ananyasindam-deepgrid/soc_1.1/Documentation/images/dojo.bmp

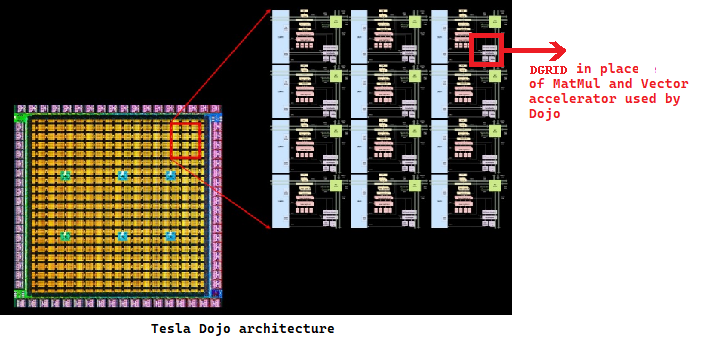
Documentation/images/dojo.bmp
