ananyasindam-deepgrid/soc_1.1/HW/riscv/xilinx_jtag/riscv.v

// Generator : SpinalHDL v1.9.3    git head : 029104c77a54c53f1edda327a3bea333f7d65fd9
// Component : riscv
// Git hash  : 5ef1bc775fdbe942875dd7906f22aa98e6cffaaf

`timescale 1ns/1ps

module riscv (
  input               io_asyncReset,
  input               io_mainClk,
  output              io_iBus_ar_valid,
  input               io_iBus_ar_ready,
  output     [31:0]   io_iBus_ar_payload_addr,
  output     [0:0]    io_iBus_ar_payload_id,
  output     [3:0]    io_iBus_ar_payload_region,
  output     [7:0]    io_iBus_ar_payload_len,
  output     [2:0]    io_iBus_ar_payload_size,
  output     [1:0]    io_iBus_ar_payload_burst,
  output     [0:0]    io_iBus_ar_payload_lock,
  output     [3:0]    io_iBus_ar_payload_cache,
  output     [3:0]    io_iBus_ar_payload_qos,
  output     [2:0]    io_iBus_ar_payload_prot,
  input               io_iBus_r_valid,
  output              io_iBus_r_ready,
  input      [31:0]   io_iBus_r_payload_data,
  input      [0:0]    io_iBus_r_payload_id,
  input      [1:0]    io_iBus_r_payload_resp,
  input               io_iBus_r_payload_last,
  output              io_dBus_aw_valid,
  input               io_dBus_aw_ready,
  output     [31:0]   io_dBus_aw_payload_addr,
  output     [0:0]    io_dBus_aw_payload_id,
  output     [3:0]    io_dBus_aw_payload_region,
  output     [7:0]    io_dBus_aw_payload_len,
  output     [2:0]    io_dBus_aw_payload_size,
  output     [1:0]    io_dBus_aw_payload_burst,
  output     [0:0]    io_dBus_aw_payload_lock,
  output     [3:0]    io_dBus_aw_payload_cache,
  output     [3:0]    io_dBus_aw_payload_qos,
  output     [2:0]    io_dBus_aw_payload_prot,
  output              io_dBus_w_valid,
  input               io_dBus_w_ready,
  output     [31:0]   io_dBus_w_payload_data,
  output     [3:0]    io_dBus_w_payload_strb,
  output              io_dBus_w_payload_last,
  input               io_dBus_b_valid,
  output              io_dBus_b_ready,
  input      [0:0]    io_dBus_b_payload_id,
  input      [1:0]    io_dBus_b_payload_resp,
  output              io_dBus_ar_valid,
  input               io_dBus_ar_ready,
  output     [31:0]   io_dBus_ar_payload_addr,
  output     [0:0]    io_dBus_ar_payload_id,
  output     [3:0]    io_dBus_ar_payload_region,
  output     [7:0]    io_dBus_ar_payload_len,
  output     [2:0]    io_dBus_ar_payload_size,
  output     [1:0]    io_dBus_ar_payload_burst,
  output     [0:0]    io_dBus_ar_payload_lock,
  output     [3:0]    io_dBus_ar_payload_cache,
  output     [3:0]    io_dBus_ar_payload_qos,
  output     [2:0]    io_dBus_ar_payload_prot,
  input               io_dBus_r_valid,
  output              io_dBus_r_ready,
  input      [31:0]   io_dBus_r_payload_data,
  input      [0:0]    io_dBus_r_payload_id,
  input      [1:0]    io_dBus_r_payload_resp,
  input               io_dBus_r_payload_last
);

  wire                system_cpu_dBus_cmd_ready;
  wire                system_cpu_dBus_rsp_payload_last;
  wire                system_cpu_dBus_rsp_payload_error;
  wire       [7:0]    system_cpu_debug_bus_cmd_payload_address;
  wire                system_cpu_iBus_rsp_payload_error;
  wire                io_asyncReset_buffercc_io_dataOut;
  wire                system_cpu_dBus_cmd_valid;
  wire                system_cpu_dBus_cmd_payload_wr;
  wire                system_cpu_dBus_cmd_payload_uncached;
  wire       [31:0]   system_cpu_dBus_cmd_payload_address;
  wire       [31:0]   system_cpu_dBus_cmd_payload_data;
  wire       [3:0]    system_cpu_dBus_cmd_payload_mask;
  wire       [2:0]    system_cpu_dBus_cmd_payload_size;
  wire                system_cpu_dBus_cmd_payload_last;
  wire                system_cpu_debug_bus_cmd_ready;
  wire       [31:0]   system_cpu_debug_bus_rsp_data;
  wire                system_cpu_debug_resetOut;
  wire                system_cpu_iBus_cmd_valid;
  wire       [31:0]   system_cpu_iBus_cmd_payload_address;
  wire       [2:0]    system_cpu_iBus_cmd_payload_size;
  wire                bSCANE2_1_CAPTURE;
  wire                bSCANE2_1_DRCK;
  wire                bSCANE2_1_RESET;
  wire                bSCANE2_1_RUNTEST;
  wire                bSCANE2_1_SEL;
  wire                bSCANE2_1_SHIFT;
  wire                bSCANE2_1_TCK;
  wire                bSCANE2_1_TDI;
  wire                bSCANE2_1_TMS;
  wire                bSCANE2_1_UPDATE;
  wire                jtagBridgeNoTap_1_io_ctrl_tdo;
  wire                jtagBridgeNoTap_1_io_remote_cmd_valid;
  wire                jtagBridgeNoTap_1_io_remote_cmd_payload_last;
  wire       [0:0]    jtagBridgeNoTap_1_io_remote_cmd_payload_fragment;
  wire                jtagBridgeNoTap_1_io_remote_rsp_ready;
  wire                systemDebugger_1_io_remote_cmd_ready;
  wire                systemDebugger_1_io_remote_rsp_valid;
  wire                systemDebugger_1_io_remote_rsp_payload_error;
  wire       [31:0]   systemDebugger_1_io_remote_rsp_payload_data;
  wire                systemDebugger_1_io_mem_cmd_valid;
  wire       [31:0]   systemDebugger_1_io_mem_cmd_payload_address;
  wire       [31:0]   systemDebugger_1_io_mem_cmd_payload_data;
  wire                systemDebugger_1_io_mem_cmd_payload_wr;
  wire       [1:0]    systemDebugger_1_io_mem_cmd_payload_size;
  wire       [2:0]    _zz_dbus_axi_arw_payload_len;
  reg                 resetCtrl_mainClkResetUnbuffered;
  reg        [5:0]    resetCtrl_systemClkResetCounter;
  wire       [5:0]    _zz_when_riscv_l155;
  wire                when_riscv_l155;
  wire                when_riscv_l159;
  reg                 resetCtrl_mainClkReset;
  reg                 resetCtrl_systemReset;
  wire                system_timerInterrupt;
  wire                system_externalInterrupt;
  wire       [0:0]    _zz_io_iBus_ar_payload_id;
  wire       [3:0]    _zz_io_iBus_ar_payload_region;
  wire                dbus_axi_arw_valid;
  wire                dbus_axi_arw_ready;
  wire       [31:0]   dbus_axi_arw_payload_addr;
  wire       [7:0]    dbus_axi_arw_payload_len;
  wire       [2:0]    dbus_axi_arw_payload_size;
  wire       [3:0]    dbus_axi_arw_payload_cache;
  wire       [2:0]    dbus_axi_arw_payload_prot;
  wire                dbus_axi_arw_payload_write;
  wire                dbus_axi_w_valid;
  wire                dbus_axi_w_ready;
  wire       [31:0]   dbus_axi_w_payload_data;
  wire       [3:0]    dbus_axi_w_payload_strb;
  wire                dbus_axi_w_payload_last;
  wire                dbus_axi_b_valid;
  wire                dbus_axi_b_ready;
  wire       [1:0]    dbus_axi_b_payload_resp;
  wire                dbus_axi_r_valid;
  wire                dbus_axi_r_ready;
  wire       [31:0]   dbus_axi_r_payload_data;
  wire       [1:0]    dbus_axi_r_payload_resp;
  wire                dbus_axi_r_payload_last;
  wire                toplevel_system_cpu_dBus_cmd_fire;
  wire                when_Utils_l659;
  wire                dbus_axi_b_fire;
  reg                 _zz_when_Utils_l687;
  reg                 _zz_when_Utils_l687_1;
  reg        [4:0]    _zz_dBus_cmd_ready;
  reg        [4:0]    _zz_dBus_cmd_ready_1;
  wire                when_Utils_l687;
  wire                when_Utils_l689;
  wire                _zz_dBus_cmd_ready_2;
  wire                _zz_dbus_axi_arw_valid;
  reg                 _zz_dBus_cmd_ready_3;
  wire                _zz_dbus_axi_arw_payload_write;
  wire                _zz_dbus_axi_w_payload_last;
  wire                _zz_dbus_axi_arw_valid_1;
  reg                 _zz_when_Stream_l998;
  wire                _zz_dbus_axi_w_valid;
  reg                 _zz_when_Stream_l998_1;
  reg                 _zz_when_Stream_l998_2;
  reg                 _zz_when_Stream_l998_3;
  wire                when_Stream_l998;
  wire                when_Stream_l998_1;
  wire                _zz_1;
  reg                 _zz_2;
  reg                 _zz_dbus_axi_arw_valid_2;
  wire                when_Stream_l439;
  reg                 _zz_dbus_axi_w_valid_1;
  wire       [0:0]    _zz_io_dBus_ar_payload_id;
  wire       [3:0]    _zz_io_dBus_ar_payload_region;
  wire       [0:0]    _zz_io_dBus_aw_payload_id;
  wire       [3:0]    _zz_io_dBus_aw_payload_region;
  reg                 toplevel_system_cpu_debug_resetOut_regNext;
  wire                toplevel_system_cpu_debug_bus_cmd_fire;
  reg                 toplevel_system_cpu_debug_bus_cmd_fire_regNext;

  assign _zz_dbus_axi_arw_payload_len = ((system_cpu_dBus_cmd_payload_size == 3'b101) ? 3'b111 : 3'b000);
  BufferCC io_asyncReset_buffercc (
    .io_dataIn  (io_asyncReset                    ), //i
    .io_dataOut (io_asyncReset_buffercc_io_dataOut), //o
    .io_mainClk (io_mainClk                       )  //i
  );
  DgsRiscv system_cpu (
    .dBus_cmd_valid                (system_cpu_dBus_cmd_valid                     ), //o
    .dBus_cmd_ready                (system_cpu_dBus_cmd_ready                     ), //i
    .dBus_cmd_payload_wr           (system_cpu_dBus_cmd_payload_wr                ), //o
    .dBus_cmd_payload_uncached     (system_cpu_dBus_cmd_payload_uncached          ), //o
    .dBus_cmd_payload_address      (system_cpu_dBus_cmd_payload_address[31:0]     ), //o
    .dBus_cmd_payload_data         (system_cpu_dBus_cmd_payload_data[31:0]        ), //o
    .dBus_cmd_payload_mask         (system_cpu_dBus_cmd_payload_mask[3:0]         ), //o
    .dBus_cmd_payload_size         (system_cpu_dBus_cmd_payload_size[2:0]         ), //o
    .dBus_cmd_payload_last         (system_cpu_dBus_cmd_payload_last              ), //o
    .dBus_rsp_valid                (dbus_axi_r_valid                              ), //i
    .dBus_rsp_payload_last         (system_cpu_dBus_rsp_payload_last              ), //i
    .dBus_rsp_payload_data         (dbus_axi_r_payload_data[31:0]                 ), //i
    .dBus_rsp_payload_error        (system_cpu_dBus_rsp_payload_error             ), //i
    .timerInterrupt                (system_timerInterrupt                         ), //i
    .externalInterrupt             (system_externalInterrupt                      ), //i
    .softwareInterrupt             (1'b0                                          ), //i
    .debug_bus_cmd_valid           (systemDebugger_1_io_mem_cmd_valid             ), //i
    .debug_bus_cmd_ready           (system_cpu_debug_bus_cmd_ready                ), //o
    .debug_bus_cmd_payload_wr      (systemDebugger_1_io_mem_cmd_payload_wr        ), //i
    .debug_bus_cmd_payload_address (system_cpu_debug_bus_cmd_payload_address[7:0] ), //i
    .debug_bus_cmd_payload_data    (systemDebugger_1_io_mem_cmd_payload_data[31:0]), //i
    .debug_bus_rsp_data            (system_cpu_debug_bus_rsp_data[31:0]           ), //o
    .debug_resetOut                (system_cpu_debug_resetOut                     ), //o
    .iBus_cmd_valid                (system_cpu_iBus_cmd_valid                     ), //o
    .iBus_cmd_ready                (io_iBus_ar_ready                              ), //i
    .iBus_cmd_payload_address      (system_cpu_iBus_cmd_payload_address[31:0]     ), //o
    .iBus_cmd_payload_size         (system_cpu_iBus_cmd_payload_size[2:0]         ), //o
    .iBus_rsp_valid                (io_iBus_r_valid                               ), //i
    .iBus_rsp_payload_data         (io_iBus_r_payload_data[31:0]                  ), //i
    .iBus_rsp_payload_error        (system_cpu_iBus_rsp_payload_error             ), //i
    .io_mainClk                    (io_mainClk                                    ), //i
    .resetCtrl_systemReset         (resetCtrl_systemReset                         ), //i
    .resetCtrl_mainClkReset        (resetCtrl_mainClkReset                        )  //i
  );
  BSCANE2 #(
    .DISABLE_JTAG("FALSE"),
    .JTAG_CHAIN(2)
  ) bSCANE2_1 (
    .CAPTURE (bSCANE2_1_CAPTURE            ), //o
    .DRCK    (bSCANE2_1_DRCK               ), //o
    .RESET   (bSCANE2_1_RESET              ), //o
    .RUNTEST (bSCANE2_1_RUNTEST            ), //o
    .SEL     (bSCANE2_1_SEL                ), //o
    .SHIFT   (bSCANE2_1_SHIFT              ), //o
    .TCK     (bSCANE2_1_TCK                ), //o
    .TDI     (bSCANE2_1_TDI                ), //o
    .TMS     (bSCANE2_1_TMS                ), //o
    .UPDATE  (bSCANE2_1_UPDATE             ), //o
    .TDO     (jtagBridgeNoTap_1_io_ctrl_tdo)  //i
  );
  JtagBridgeNoTap jtagBridgeNoTap_1 (
    .io_ctrl_tdi                    (bSCANE2_1_TDI                                    ), //i
    .io_ctrl_enable                 (bSCANE2_1_SEL                                    ), //i
    .io_ctrl_capture                (bSCANE2_1_CAPTURE                                ), //i
    .io_ctrl_shift                  (bSCANE2_1_SHIFT                                  ), //i
    .io_ctrl_update                 (bSCANE2_1_UPDATE                                 ), //i
    .io_ctrl_reset                  (bSCANE2_1_RESET                                  ), //i
    .io_ctrl_tdo                    (jtagBridgeNoTap_1_io_ctrl_tdo                    ), //o
    .io_remote_cmd_valid            (jtagBridgeNoTap_1_io_remote_cmd_valid            ), //o
    .io_remote_cmd_ready            (systemDebugger_1_io_remote_cmd_ready             ), //i
    .io_remote_cmd_payload_last     (jtagBridgeNoTap_1_io_remote_cmd_payload_last     ), //o
    .io_remote_cmd_payload_fragment (jtagBridgeNoTap_1_io_remote_cmd_payload_fragment ), //o
    .io_remote_rsp_valid            (systemDebugger_1_io_remote_rsp_valid             ), //i
    .io_remote_rsp_ready            (jtagBridgeNoTap_1_io_remote_rsp_ready            ), //o
    .io_remote_rsp_payload_error    (systemDebugger_1_io_remote_rsp_payload_error     ), //i
    .io_remote_rsp_payload_data     (systemDebugger_1_io_remote_rsp_payload_data[31:0]), //i
    .io_mainClk                     (io_mainClk                                       ), //i
    .resetCtrl_mainClkReset         (resetCtrl_mainClkReset                           ), //i
    .TCK                            (bSCANE2_1_TCK                                    )  //i
  );
  SystemDebugger systemDebugger_1 (
    .io_remote_cmd_valid            (jtagBridgeNoTap_1_io_remote_cmd_valid            ), //i
    .io_remote_cmd_ready            (systemDebugger_1_io_remote_cmd_ready             ), //o
    .io_remote_cmd_payload_last     (jtagBridgeNoTap_1_io_remote_cmd_payload_last     ), //i
    .io_remote_cmd_payload_fragment (jtagBridgeNoTap_1_io_remote_cmd_payload_fragment ), //i
    .io_remote_rsp_valid            (systemDebugger_1_io_remote_rsp_valid             ), //o
    .io_remote_rsp_ready            (jtagBridgeNoTap_1_io_remote_rsp_ready            ), //i
    .io_remote_rsp_payload_error    (systemDebugger_1_io_remote_rsp_payload_error     ), //o
    .io_remote_rsp_payload_data     (systemDebugger_1_io_remote_rsp_payload_data[31:0]), //o
    .io_mem_cmd_valid               (systemDebugger_1_io_mem_cmd_valid                ), //o
    .io_mem_cmd_ready               (system_cpu_debug_bus_cmd_ready                   ), //i
    .io_mem_cmd_payload_address     (systemDebugger_1_io_mem_cmd_payload_address[31:0]), //o
    .io_mem_cmd_payload_data        (systemDebugger_1_io_mem_cmd_payload_data[31:0]   ), //o
    .io_mem_cmd_payload_wr          (systemDebugger_1_io_mem_cmd_payload_wr           ), //o
    .io_mem_cmd_payload_size        (systemDebugger_1_io_mem_cmd_payload_size[1:0]    ), //o
    .io_mem_rsp_valid               (toplevel_system_cpu_debug_bus_cmd_fire_regNext   ), //i
    .io_mem_rsp_payload             (system_cpu_debug_bus_rsp_data[31:0]              ), //i
    .io_mainClk                     (io_mainClk                                       ), //i
    .resetCtrl_mainClkReset         (resetCtrl_mainClkReset                           )  //i
  );
  initial begin
    resetCtrl_systemClkResetCounter = 6'h00;
  end

  always @(*) begin
    resetCtrl_mainClkResetUnbuffered = 1'b0;
    if(when_riscv_l155) begin
      resetCtrl_mainClkResetUnbuffered = 1'b1;
    end
  end

  assign _zz_when_riscv_l155[5 : 0] = 6'h3f;
  assign when_riscv_l155 = (resetCtrl_systemClkResetCounter != _zz_when_riscv_l155);
  assign when_riscv_l159 = io_asyncReset_buffercc_io_dataOut;
  assign system_timerInterrupt = 1'b0;
  assign system_externalInterrupt = 1'b0;
  assign system_cpu_iBus_rsp_payload_error = (! (io_iBus_r_payload_resp == 2'b00));
  assign _zz_io_iBus_ar_payload_id[0 : 0] = 1'b0;
  assign _zz_io_iBus_ar_payload_region[3 : 0] = 4'b0000;
  assign toplevel_system_cpu_dBus_cmd_fire = (system_cpu_dBus_cmd_valid && system_cpu_dBus_cmd_ready);
  assign when_Utils_l659 = (toplevel_system_cpu_dBus_cmd_fire && system_cpu_dBus_cmd_payload_wr);
  assign dbus_axi_b_fire = (dbus_axi_b_valid && dbus_axi_b_ready);
  always @(*) begin
    _zz_when_Utils_l687 = 1'b0;
    if(when_Utils_l659) begin
      _zz_when_Utils_l687 = 1'b1;
    end
  end

  always @(*) begin
    _zz_when_Utils_l687_1 = 1'b0;
    if(dbus_axi_b_fire) begin
      _zz_when_Utils_l687_1 = 1'b1;
    end
  end

  assign when_Utils_l687 = (_zz_when_Utils_l687 && (! _zz_when_Utils_l687_1));
  always @(*) begin
    if(when_Utils_l687) begin
      _zz_dBus_cmd_ready_1 = 5'h01;
    end else begin
      if(when_Utils_l689) begin
        _zz_dBus_cmd_ready_1 = 5'h1f;
      end else begin
        _zz_dBus_cmd_ready_1 = 5'h00;
      end
    end
  end

  assign when_Utils_l689 = ((! _zz_when_Utils_l687) && _zz_when_Utils_l687_1);
  assign _zz_dBus_cmd_ready_2 = (! (((_zz_dBus_cmd_ready != 5'h00) && (! system_cpu_dBus_cmd_payload_wr)) || (_zz_dBus_cmd_ready == 5'h1f)));
  assign _zz_dbus_axi_arw_valid = (system_cpu_dBus_cmd_valid && _zz_dBus_cmd_ready_2);
  assign system_cpu_dBus_cmd_ready = (_zz_dBus_cmd_ready_3 && _zz_dBus_cmd_ready_2);
  assign _zz_dbus_axi_arw_payload_write = system_cpu_dBus_cmd_payload_wr;
  assign _zz_dbus_axi_w_payload_last = system_cpu_dBus_cmd_payload_last;
  always @(*) begin
    _zz_dBus_cmd_ready_3 = 1'b1;
    if(when_Stream_l998) begin
      _zz_dBus_cmd_ready_3 = 1'b0;
    end
    if(when_Stream_l998_1) begin
      _zz_dBus_cmd_ready_3 = 1'b0;
    end
  end

  assign when_Stream_l998 = ((! _zz_when_Stream_l998) && _zz_when_Stream_l998_2);
  assign when_Stream_l998_1 = ((! _zz_when_Stream_l998_1) && _zz_when_Stream_l998_3);
  assign _zz_dbus_axi_arw_valid_1 = (_zz_dbus_axi_arw_valid && _zz_when_Stream_l998_2);
  assign _zz_1 = (_zz_dbus_axi_arw_valid_1 && _zz_when_Stream_l998);
  assign _zz_dbus_axi_w_valid = (_zz_dbus_axi_arw_valid && _zz_when_Stream_l998_3);
  always @(*) begin
    _zz_dbus_axi_arw_valid_2 = _zz_dbus_axi_arw_valid_1;
    if(_zz_2) begin
      _zz_dbus_axi_arw_valid_2 = 1'b0;
    end
  end

  always @(*) begin
    _zz_when_Stream_l998 = dbus_axi_arw_ready;
    if(_zz_2) begin
      _zz_when_Stream_l998 = 1'b1;
    end
  end

  assign when_Stream_l439 = (! _zz_dbus_axi_arw_payload_write);
  always @(*) begin
    _zz_dbus_axi_w_valid_1 = _zz_dbus_axi_w_valid;
    if(when_Stream_l439) begin
      _zz_dbus_axi_w_valid_1 = 1'b0;
    end
  end

  always @(*) begin
    _zz_when_Stream_l998_1 = dbus_axi_w_ready;
    if(when_Stream_l439) begin
      _zz_when_Stream_l998_1 = 1'b1;
    end
  end

  assign dbus_axi_arw_valid = _zz_dbus_axi_arw_valid_2;
  assign dbus_axi_arw_payload_write = _zz_dbus_axi_arw_payload_write;
  assign dbus_axi_arw_payload_prot = 3'b010;
  assign dbus_axi_arw_payload_cache = 4'b1111;
  assign dbus_axi_arw_payload_size = 3'b010;
  assign dbus_axi_arw_payload_addr = system_cpu_dBus_cmd_payload_address;
  assign dbus_axi_arw_payload_len = {5'd0, _zz_dbus_axi_arw_payload_len};
  assign dbus_axi_w_valid = _zz_dbus_axi_w_valid_1;
  assign dbus_axi_w_payload_data = system_cpu_dBus_cmd_payload_data;
  assign dbus_axi_w_payload_strb = system_cpu_dBus_cmd_payload_mask;
  assign dbus_axi_w_payload_last = _zz_dbus_axi_w_payload_last;
  assign system_cpu_dBus_rsp_payload_error = (! (dbus_axi_r_payload_resp == 2'b00));
  assign dbus_axi_r_ready = 1'b1;
  assign dbus_axi_b_ready = 1'b1;
  assign dbus_axi_arw_ready = (dbus_axi_arw_payload_write ? io_dBus_aw_ready : io_dBus_ar_ready);
  assign dbus_axi_w_ready = io_dBus_w_ready;
  assign dbus_axi_r_valid = io_dBus_r_valid;
  assign dbus_axi_r_payload_data = io_dBus_r_payload_data;
  assign dbus_axi_r_payload_resp = io_dBus_r_payload_resp;
  assign dbus_axi_r_payload_last = io_dBus_r_payload_last;
  assign dbus_axi_b_valid = io_dBus_b_valid;
  assign dbus_axi_b_payload_resp = io_dBus_b_payload_resp;
  assign _zz_io_dBus_ar_payload_id[0 : 0] = 1'b0;
  assign _zz_io_dBus_ar_payload_region[3 : 0] = 4'b0000;
  assign _zz_io_dBus_aw_payload_id[0 : 0] = 1'b0;
  assign _zz_io_dBus_aw_payload_region[3 : 0] = 4'b0000;
  assign system_cpu_debug_bus_cmd_payload_address = systemDebugger_1_io_mem_cmd_payload_address[7:0];
  assign toplevel_system_cpu_debug_bus_cmd_fire = (systemDebugger_1_io_mem_cmd_valid && system_cpu_debug_bus_cmd_ready);
  assign io_iBus_ar_valid = system_cpu_iBus_cmd_valid;
  assign io_iBus_ar_payload_addr = system_cpu_iBus_cmd_payload_address;
  assign io_iBus_ar_payload_id = _zz_io_iBus_ar_payload_id;
  assign io_iBus_ar_payload_region = _zz_io_iBus_ar_payload_region;
  assign io_iBus_ar_payload_len = 8'h07;
  assign io_iBus_ar_payload_size = 3'b010;
  assign io_iBus_ar_payload_burst = 2'b01;
  assign io_iBus_ar_payload_lock = 1'b0;
  assign io_iBus_ar_payload_cache = 4'b1111;
  assign io_iBus_ar_payload_qos = 4'b0000;
  assign io_iBus_ar_payload_prot = 3'b110;
  assign io_iBus_r_ready = 1'b1;
  assign io_dBus_aw_valid = (dbus_axi_arw_valid && dbus_axi_arw_payload_write);
  assign io_dBus_aw_payload_addr = dbus_axi_arw_payload_addr;
  assign io_dBus_aw_payload_id = _zz_io_dBus_aw_payload_id;
  assign io_dBus_aw_payload_region = _zz_io_dBus_aw_payload_region;
  assign io_dBus_aw_payload_len = dbus_axi_arw_payload_len;
  assign io_dBus_aw_payload_size = dbus_axi_arw_payload_size;
  assign io_dBus_aw_payload_burst = 2'b01;
  assign io_dBus_aw_payload_lock = 1'b0;
  assign io_dBus_aw_payload_cache = dbus_axi_arw_payload_cache;
  assign io_dBus_aw_payload_qos = 4'b0000;
  assign io_dBus_aw_payload_prot = dbus_axi_arw_payload_prot;
  assign io_dBus_w_valid = dbus_axi_w_valid;
  assign io_dBus_w_payload_data = dbus_axi_w_payload_data;
  assign io_dBus_w_payload_strb = dbus_axi_w_payload_strb;
  assign io_dBus_w_payload_last = dbus_axi_w_payload_last;
  assign io_dBus_b_ready = dbus_axi_b_ready;
  assign io_dBus_ar_valid = (dbus_axi_arw_valid && (! dbus_axi_arw_payload_write));
  assign io_dBus_ar_payload_addr = dbus_axi_arw_payload_addr;
  assign io_dBus_ar_payload_id = _zz_io_dBus_ar_payload_id;
  assign io_dBus_ar_payload_region = _zz_io_dBus_ar_payload_region;
  assign io_dBus_ar_payload_len = dbus_axi_arw_payload_len;
  assign io_dBus_ar_payload_size = dbus_axi_arw_payload_size;
  assign io_dBus_ar_payload_burst = 2'b01;
  assign io_dBus_ar_payload_lock = 1'b0;
  assign io_dBus_ar_payload_cache = dbus_axi_arw_payload_cache;
  assign io_dBus_ar_payload_qos = 4'b0000;
  assign io_dBus_ar_payload_prot = dbus_axi_arw_payload_prot;
  assign io_dBus_r_ready = dbus_axi_r_ready;
  always @(posedge io_mainClk) begin
    if(when_riscv_l155) begin
      resetCtrl_systemClkResetCounter <= (resetCtrl_systemClkResetCounter + 6'h01);
    end
    if(when_riscv_l159) begin
      resetCtrl_systemClkResetCounter <= 6'h00;
    end
  end

  always @(posedge io_mainClk) begin
    resetCtrl_mainClkReset <= resetCtrl_mainClkResetUnbuffered;
    resetCtrl_systemReset <= resetCtrl_mainClkResetUnbuffered;
    if(toplevel_system_cpu_debug_resetOut_regNext) begin
      resetCtrl_systemReset <= 1'b1;
    end
  end

  always @(posedge io_mainClk or posedge resetCtrl_systemReset) begin
    if(resetCtrl_systemReset) begin
      _zz_dBus_cmd_ready <= 5'h00;
      _zz_when_Stream_l998_2 <= 1'b1;
      _zz_when_Stream_l998_3 <= 1'b1;
      _zz_2 <= 1'b0;
    end else begin
      _zz_dBus_cmd_ready <= (_zz_dBus_cmd_ready + _zz_dBus_cmd_ready_1);
      if(_zz_1) begin
        _zz_when_Stream_l998_2 <= 1'b0;
      end
      if((_zz_dbus_axi_w_valid && _zz_when_Stream_l998_1)) begin
        _zz_when_Stream_l998_3 <= 1'b0;
      end
      if(_zz_dBus_cmd_ready_3) begin
        _zz_when_Stream_l998_2 <= 1'b1;
        _zz_when_Stream_l998_3 <= 1'b1;
      end
      if(_zz_1) begin
        _zz_2 <= (! _zz_dbus_axi_w_payload_last);
      end
    end
  end

  always @(posedge io_mainClk) begin
    toplevel_system_cpu_debug_resetOut_regNext <= system_cpu_debug_resetOut;
  end

  always @(posedge io_mainClk or posedge resetCtrl_mainClkReset) begin
    if(resetCtrl_mainClkReset) begin
      toplevel_system_cpu_debug_bus_cmd_fire_regNext <= 1'b0;
    end else begin
      toplevel_system_cpu_debug_bus_cmd_fire_regNext <= toplevel_system_cpu_debug_bus_cmd_fire;
    end
  end


endmodule

module SystemDebugger (
  input               io_remote_cmd_valid,
  output              io_remote_cmd_ready,
  input               io_remote_cmd_payload_last,
  input      [0:0]    io_remote_cmd_payload_fragment,
  output              io_remote_rsp_valid,
  input               io_remote_rsp_ready,
  output              io_remote_rsp_payload_error,
  output     [31:0]   io_remote_rsp_payload_data,
  output              io_mem_cmd_valid,
  input               io_mem_cmd_ready,
  output     [31:0]   io_mem_cmd_payload_address,
  output     [31:0]   io_mem_cmd_payload_data,
  output              io_mem_cmd_payload_wr,
  output     [1:0]    io_mem_cmd_payload_size,
  input               io_mem_rsp_valid,
  input      [31:0]   io_mem_rsp_payload,
  input               io_mainClk,
  input               resetCtrl_mainClkReset
);

  reg        [66:0]   dispatcher_dataShifter;
  reg                 dispatcher_dataLoaded;
  reg        [7:0]    dispatcher_headerShifter;
  wire       [7:0]    dispatcher_header;
  reg                 dispatcher_headerLoaded;
  reg        [2:0]    dispatcher_counter;
  wire                when_Fragment_l356;
  wire                when_Fragment_l359;
  wire       [66:0]   _zz_io_mem_cmd_payload_address;
  wire                io_mem_cmd_isStall;
  wire                when_Fragment_l382;

  assign dispatcher_header = dispatcher_headerShifter[7 : 0];
  assign when_Fragment_l356 = (dispatcher_headerLoaded == 1'b0);
  assign when_Fragment_l359 = (dispatcher_counter == 3'b111);
  assign io_remote_cmd_ready = (! dispatcher_dataLoaded);
  assign _zz_io_mem_cmd_payload_address = dispatcher_dataShifter[66 : 0];
  assign io_mem_cmd_payload_address = _zz_io_mem_cmd_payload_address[31 : 0];
  assign io_mem_cmd_payload_data = _zz_io_mem_cmd_payload_address[63 : 32];
  assign io_mem_cmd_payload_wr = _zz_io_mem_cmd_payload_address[64];
  assign io_mem_cmd_payload_size = _zz_io_mem_cmd_payload_address[66 : 65];
  assign io_mem_cmd_valid = (dispatcher_dataLoaded && (dispatcher_header == 8'h00));
  assign io_mem_cmd_isStall = (io_mem_cmd_valid && (! io_mem_cmd_ready));
  assign when_Fragment_l382 = ((dispatcher_headerLoaded && dispatcher_dataLoaded) && (! io_mem_cmd_isStall));
  assign io_remote_rsp_valid = io_mem_rsp_valid;
  assign io_remote_rsp_payload_error = 1'b0;
  assign io_remote_rsp_payload_data = io_mem_rsp_payload;
  always @(posedge io_mainClk or posedge resetCtrl_mainClkReset) begin
    if(resetCtrl_mainClkReset) begin
      dispatcher_dataLoaded <= 1'b0;
      dispatcher_headerLoaded <= 1'b0;
      dispatcher_counter <= 3'b000;
    end else begin
      if(io_remote_cmd_valid) begin
        if(when_Fragment_l356) begin
          dispatcher_counter <= (dispatcher_counter + 3'b001);
          if(when_Fragment_l359) begin
            dispatcher_headerLoaded <= 1'b1;
          end
        end
        if(io_remote_cmd_payload_last) begin
          dispatcher_headerLoaded <= 1'b1;
          dispatcher_dataLoaded <= 1'b1;
          dispatcher_counter <= 3'b000;
        end
      end
      if(when_Fragment_l382) begin
        dispatcher_headerLoaded <= 1'b0;
        dispatcher_dataLoaded <= 1'b0;
      end
    end
  end

  always @(posedge io_mainClk) begin
    if(io_remote_cmd_valid) begin
      if(when_Fragment_l356) begin
        dispatcher_headerShifter <= ({io_remote_cmd_payload_fragment,dispatcher_headerShifter} >>> 1'd1);
      end else begin
        dispatcher_dataShifter <= ({io_remote_cmd_payload_fragment,dispatcher_dataShifter} >>> 1'd1);
      end
    end
  end


endmodule

module JtagBridgeNoTap (
  input               io_ctrl_tdi,
  input               io_ctrl_enable,
  input               io_ctrl_capture,
  input               io_ctrl_shift,
  input               io_ctrl_update,
  input               io_ctrl_reset,
  output              io_ctrl_tdo,
  output              io_remote_cmd_valid,
  input               io_remote_cmd_ready,
  output              io_remote_cmd_payload_last,
  output     [0:0]    io_remote_cmd_payload_fragment,
  input               io_remote_rsp_valid,
  output              io_remote_rsp_ready,
  input               io_remote_rsp_payload_error,
  input      [31:0]   io_remote_rsp_payload_data,
  input               io_mainClk,
  input               resetCtrl_mainClkReset,
  input               TCK
);

  wire                flowCCByToggle_1_io_output_valid;
  wire                flowCCByToggle_1_io_output_payload_last;
  wire       [0:0]    flowCCByToggle_1_io_output_payload_fragment;
  wire                system_cmd_valid;
  wire                system_cmd_payload_last;
  wire       [0:0]    system_cmd_payload_fragment;
  wire                system_cmd_toStream_valid;
  wire                system_cmd_toStream_ready;
  wire                system_cmd_toStream_payload_last;
  wire       [0:0]    system_cmd_toStream_payload_fragment;
  (* async_reg = "true" *) reg                 system_rsp_valid;
  (* async_reg = "true" *) reg                 system_rsp_payload_error;
  (* async_reg = "true" *) reg        [31:0]   system_rsp_payload_data;
  wire                io_remote_rsp_fire;
  wire                jtag_wrapper_ctrl_tdi;
  wire                jtag_wrapper_ctrl_enable;
  wire                jtag_wrapper_ctrl_capture;
  wire                jtag_wrapper_ctrl_shift;
  wire                jtag_wrapper_ctrl_update;
  wire                jtag_wrapper_ctrl_reset;
  reg                 jtag_wrapper_ctrl_tdo;
  reg        [1:0]    jtag_wrapper_header;
  wire       [1:0]    jtag_wrapper_headerNext;
  reg        [0:0]    jtag_wrapper_counter;
  reg                 jtag_wrapper_done;
  reg                 jtag_wrapper_sendCapture;
  reg                 jtag_wrapper_sendShift;
  reg                 jtag_wrapper_sendUpdate;
  wire                when_JtagTapInstructions_l183;
  wire                when_JtagTapInstructions_l186;
  wire                jtag_writeArea_ctrl_tdi;
  wire                jtag_writeArea_ctrl_enable;
  wire                jtag_writeArea_ctrl_capture;
  wire                jtag_writeArea_ctrl_shift;
  wire                jtag_writeArea_ctrl_update;
  wire                jtag_writeArea_ctrl_reset;
  wire                jtag_writeArea_ctrl_tdo;
  wire                jtag_writeArea_source_valid;
  wire                jtag_writeArea_source_payload_last;
  wire       [0:0]    jtag_writeArea_source_payload_fragment;
  reg                 jtag_writeArea_valid;
  reg                 jtag_writeArea_data;
  wire                when_JtagTapInstructions_l209;
  wire                jtag_readArea_ctrl_tdi;
  wire                jtag_readArea_ctrl_enable;
  wire                jtag_readArea_ctrl_capture;
  wire                jtag_readArea_ctrl_shift;
  wire                jtag_readArea_ctrl_update;
  wire                jtag_readArea_ctrl_reset;
  wire                jtag_readArea_ctrl_tdo;
  reg        [33:0]   jtag_readArea_full_shifter;
  wire                when_JtagTapInstructions_l209_1;

  FlowCCByToggle flowCCByToggle_1 (
    .io_input_valid             (jtag_writeArea_source_valid                ), //i
    .io_input_payload_last      (jtag_writeArea_source_payload_last         ), //i
    .io_input_payload_fragment  (jtag_writeArea_source_payload_fragment     ), //i
    .io_output_valid            (flowCCByToggle_1_io_output_valid           ), //o
    .io_output_payload_last     (flowCCByToggle_1_io_output_payload_last    ), //o
    .io_output_payload_fragment (flowCCByToggle_1_io_output_payload_fragment), //o
    .TCK                        (TCK                                        ), //i
    .io_mainClk                 (io_mainClk                                 ), //i
    .resetCtrl_mainClkReset     (resetCtrl_mainClkReset                     )  //i
  );
  assign system_cmd_toStream_valid = system_cmd_valid;
  assign system_cmd_toStream_payload_last = system_cmd_payload_last;
  assign system_cmd_toStream_payload_fragment = system_cmd_payload_fragment;
  assign io_remote_cmd_valid = system_cmd_toStream_valid;
  assign system_cmd_toStream_ready = io_remote_cmd_ready;
  assign io_remote_cmd_payload_last = system_cmd_toStream_payload_last;
  assign io_remote_cmd_payload_fragment = system_cmd_toStream_payload_fragment;
  assign io_remote_rsp_fire = (io_remote_rsp_valid && io_remote_rsp_ready);
  assign io_remote_rsp_ready = 1'b1;
  assign jtag_wrapper_headerNext = ({jtag_wrapper_ctrl_tdi,jtag_wrapper_header} >>> 1'd1);
  always @(*) begin
    jtag_wrapper_sendCapture = 1'b0;
    if(jtag_wrapper_ctrl_enable) begin
      if(jtag_wrapper_ctrl_shift) begin
        if(when_JtagTapInstructions_l183) begin
          if(when_JtagTapInstructions_l186) begin
            jtag_wrapper_sendCapture = 1'b1;
          end
        end
      end
    end
  end

  always @(*) begin
    jtag_wrapper_sendShift = 1'b0;
    if(jtag_wrapper_ctrl_enable) begin
      if(jtag_wrapper_ctrl_shift) begin
        if(!when_JtagTapInstructions_l183) begin
          jtag_wrapper_sendShift = 1'b1;
        end
      end
    end
  end

  always @(*) begin
    jtag_wrapper_sendUpdate = 1'b0;
    if(jtag_wrapper_ctrl_enable) begin
      if(jtag_wrapper_ctrl_update) begin
        jtag_wrapper_sendUpdate = 1'b1;
      end
    end
  end

  assign when_JtagTapInstructions_l183 = (! jtag_wrapper_done);
  assign when_JtagTapInstructions_l186 = (jtag_wrapper_counter == 1'b1);
  always @(*) begin
    jtag_wrapper_ctrl_tdo = 1'b0;
    if(when_JtagTapInstructions_l209) begin
      jtag_wrapper_ctrl_tdo = jtag_writeArea_ctrl_tdo;
    end
    if(when_JtagTapInstructions_l209_1) begin
      jtag_wrapper_ctrl_tdo = jtag_readArea_ctrl_tdo;
    end
  end

  assign jtag_wrapper_ctrl_tdi = io_ctrl_tdi;
  assign jtag_wrapper_ctrl_enable = io_ctrl_enable;
  assign jtag_wrapper_ctrl_capture = io_ctrl_capture;
  assign jtag_wrapper_ctrl_shift = io_ctrl_shift;
  assign jtag_wrapper_ctrl_update = io_ctrl_update;
  assign jtag_wrapper_ctrl_reset = io_ctrl_reset;
  assign io_ctrl_tdo = jtag_wrapper_ctrl_tdo;
  assign jtag_writeArea_source_valid = jtag_writeArea_valid;
  assign jtag_writeArea_source_payload_last = (! (jtag_writeArea_ctrl_enable && jtag_writeArea_ctrl_shift));
  assign jtag_writeArea_source_payload_fragment[0] = jtag_writeArea_data;
  assign system_cmd_valid = flowCCByToggle_1_io_output_valid;
  assign system_cmd_payload_last = flowCCByToggle_1_io_output_payload_last;
  assign system_cmd_payload_fragment = flowCCByToggle_1_io_output_payload_fragment;
  assign jtag_writeArea_ctrl_tdo = 1'b0;
  assign when_JtagTapInstructions_l209 = (jtag_wrapper_header == 2'b00);
  assign jtag_writeArea_ctrl_tdi = jtag_wrapper_ctrl_tdi;
  assign jtag_writeArea_ctrl_enable = 1'b1;
  assign jtag_writeArea_ctrl_capture = ((jtag_wrapper_headerNext == 2'b00) && jtag_wrapper_sendCapture);
  assign jtag_writeArea_ctrl_shift = (when_JtagTapInstructions_l209 && jtag_wrapper_sendShift);
  assign jtag_writeArea_ctrl_update = (when_JtagTapInstructions_l209 && jtag_wrapper_sendUpdate);
  assign jtag_writeArea_ctrl_reset = jtag_wrapper_ctrl_reset;
  assign jtag_readArea_ctrl_tdo = jtag_readArea_full_shifter[0];
  assign when_JtagTapInstructions_l209_1 = (jtag_wrapper_header == 2'b01);
  assign jtag_readArea_ctrl_tdi = jtag_wrapper_ctrl_tdi;
  assign jtag_readArea_ctrl_enable = 1'b1;
  assign jtag_readArea_ctrl_capture = ((jtag_wrapper_headerNext == 2'b01) && jtag_wrapper_sendCapture);
  assign jtag_readArea_ctrl_shift = (when_JtagTapInstructions_l209_1 && jtag_wrapper_sendShift);
  assign jtag_readArea_ctrl_update = (when_JtagTapInstructions_l209_1 && jtag_wrapper_sendUpdate);
  assign jtag_readArea_ctrl_reset = jtag_wrapper_ctrl_reset;
  always @(posedge io_mainClk) begin
    if(io_remote_cmd_valid) begin
      system_rsp_valid <= 1'b0;
    end
    if(io_remote_rsp_fire) begin
      system_rsp_valid <= 1'b1;
      system_rsp_payload_error <= io_remote_rsp_payload_error;
      system_rsp_payload_data <= io_remote_rsp_payload_data;
    end
  end

  always @(posedge TCK) begin
    if(jtag_wrapper_ctrl_enable) begin
      if(jtag_wrapper_ctrl_capture) begin
        jtag_wrapper_done <= 1'b0;
        jtag_wrapper_counter <= 1'b0;
      end
      if(jtag_wrapper_ctrl_shift) begin
        if(when_JtagTapInstructions_l183) begin
          jtag_wrapper_counter <= (jtag_wrapper_counter + 1'b1);
          jtag_wrapper_header <= jtag_wrapper_headerNext;
          if(when_JtagTapInstructions_l186) begin
            jtag_wrapper_done <= 1'b1;
          end
        end
      end
    end
    jtag_writeArea_valid <= (jtag_writeArea_ctrl_enable && jtag_writeArea_ctrl_shift);
    jtag_writeArea_data <= jtag_writeArea_ctrl_tdi;
    if(jtag_readArea_ctrl_enable) begin
      if(jtag_readArea_ctrl_capture) begin
        jtag_readArea_full_shifter <= {{system_rsp_payload_data,system_rsp_payload_error},system_rsp_valid};
      end
      if(jtag_readArea_ctrl_shift) begin
        jtag_readArea_full_shifter <= ({jtag_readArea_ctrl_tdi,jtag_readArea_full_shifter} >>> 1'd1);
      end
    end
  end


endmodule

module DgsRiscv (
  output              dBus_cmd_valid,
  input               dBus_cmd_ready,
  output              dBus_cmd_payload_wr,
  output              dBus_cmd_payload_uncached,
  output     [31:0]   dBus_cmd_payload_address,
  output     [31:0]   dBus_cmd_payload_data,
  output     [3:0]    dBus_cmd_payload_mask,
  output     [2:0]    dBus_cmd_payload_size,
  output              dBus_cmd_payload_last,
  input               dBus_rsp_valid,
  input               dBus_rsp_payload_last,
  input      [31:0]   dBus_rsp_payload_data,
  input               dBus_rsp_payload_error,
  input               timerInterrupt,
  input               externalInterrupt,
  input               softwareInterrupt,
  input               debug_bus_cmd_valid,
  output reg          debug_bus_cmd_ready,
  input               debug_bus_cmd_payload_wr,
  input      [7:0]    debug_bus_cmd_payload_address,
  input      [31:0]   debug_bus_cmd_payload_data,
  output reg [31:0]   debug_bus_rsp_data,
  output              debug_resetOut,
  output              iBus_cmd_valid,
  input               iBus_cmd_ready,
  output reg [31:0]   iBus_cmd_payload_address,
  output     [2:0]    iBus_cmd_payload_size,
  input               iBus_rsp_valid,
  input      [31:0]   iBus_rsp_payload_data,
  input               iBus_rsp_payload_error,
  input               io_mainClk,
  input               resetCtrl_systemReset,
  input               resetCtrl_mainClkReset
);
  localparam BranchCtrlEnum_INC = 2'd0;
  localparam BranchCtrlEnum_B = 2'd1;
  localparam BranchCtrlEnum_JAL = 2'd2;
  localparam BranchCtrlEnum_JALR = 2'd3;
  localparam ShiftCtrlEnum_DISABLE_1 = 2'd0;
  localparam ShiftCtrlEnum_SLL_1 = 2'd1;
  localparam ShiftCtrlEnum_SRL_1 = 2'd2;
  localparam ShiftCtrlEnum_SRA_1 = 2'd3;
  localparam AluBitwiseCtrlEnum_XOR_1 = 2'd0;
  localparam AluBitwiseCtrlEnum_OR_1 = 2'd1;
  localparam AluBitwiseCtrlEnum_AND_1 = 2'd2;
  localparam EnvCtrlEnum_NONE = 1'd0;
  localparam EnvCtrlEnum_XRET = 1'd1;
  localparam Src2CtrlEnum_RS = 2'd0;
  localparam Src2CtrlEnum_IMI = 2'd1;
  localparam Src2CtrlEnum_IMS = 2'd2;
  localparam Src2CtrlEnum_PC = 2'd3;
  localparam AluCtrlEnum_ADD_SUB = 2'd0;
  localparam AluCtrlEnum_SLT_SLTU = 2'd1;
  localparam AluCtrlEnum_BITWISE = 2'd2;
  localparam Src1CtrlEnum_RS = 2'd0;
  localparam Src1CtrlEnum_IMU = 2'd1;
  localparam Src1CtrlEnum_PC_INCREMENT = 2'd2;
  localparam Src1CtrlEnum_URS1 = 2'd3;

  wire                IBusCachedPlugin_cache_io_flush;
  wire                IBusCachedPlugin_cache_io_cpu_prefetch_isValid;
  wire                IBusCachedPlugin_cache_io_cpu_fetch_isValid;
  wire                IBusCachedPlugin_cache_io_cpu_fetch_isStuck;
  wire                IBusCachedPlugin_cache_io_cpu_fetch_isRemoved;
  wire                IBusCachedPlugin_cache_io_cpu_decode_isValid;
  wire                IBusCachedPlugin_cache_io_cpu_decode_isStuck;
  wire                IBusCachedPlugin_cache_io_cpu_decode_isUser;
  reg                 IBusCachedPlugin_cache_io_cpu_fill_valid;
  wire                dataCache_1_io_cpu_execute_isValid;
  wire       [31:0]   dataCache_1_io_cpu_execute_address;
  wire                dataCache_1_io_cpu_memory_isValid;
  wire       [31:0]   dataCache_1_io_cpu_memory_address;
  reg                 dataCache_1_io_cpu_memory_mmuRsp_isIoAccess;
  reg                 dataCache_1_io_cpu_writeBack_isValid;
  wire                dataCache_1_io_cpu_writeBack_isUser;
  wire       [31:0]   dataCache_1_io_cpu_writeBack_storeData;
  wire       [31:0]   dataCache_1_io_cpu_writeBack_address;
  wire                dataCache_1_io_cpu_writeBack_fence_SW;
  wire                dataCache_1_io_cpu_writeBack_fence_SR;
  wire                dataCache_1_io_cpu_writeBack_fence_SO;
  wire                dataCache_1_io_cpu_writeBack_fence_SI;
  wire                dataCache_1_io_cpu_writeBack_fence_PW;
  wire                dataCache_1_io_cpu_writeBack_fence_PR;
  wire                dataCache_1_io_cpu_writeBack_fence_PO;
  wire                dataCache_1_io_cpu_writeBack_fence_PI;
  wire       [3:0]    dataCache_1_io_cpu_writeBack_fence_FM;
  wire                dataCache_1_io_cpu_flush_valid;
  wire                dataCache_1_io_cpu_flush_payload_singleLine;
  wire       [7:0]    dataCache_1_io_cpu_flush_payload_lineId;
  reg        [55:0]   _zz_IBusCachedPlugin_predictor_history_port1;
  wire       [31:0]   _zz_RegFilePlugin_regFile_port0;
  wire       [31:0]   _zz_RegFilePlugin_regFile_port1;
  wire                IBusCachedPlugin_cache_io_cpu_prefetch_haltIt;
  wire       [31:0]   IBusCachedPlugin_cache_io_cpu_fetch_data;
  wire       [31:0]   IBusCachedPlugin_cache_io_cpu_fetch_physicalAddress;
  wire                IBusCachedPlugin_cache_io_cpu_decode_error;
  wire                IBusCachedPlugin_cache_io_cpu_decode_mmuRefilling;
  wire                IBusCachedPlugin_cache_io_cpu_decode_mmuException;
  wire       [31:0]   IBusCachedPlugin_cache_io_cpu_decode_data;
  wire                IBusCachedPlugin_cache_io_cpu_decode_cacheMiss;
  wire       [31:0]   IBusCachedPlugin_cache_io_cpu_decode_physicalAddress;
  wire                IBusCachedPlugin_cache_io_mem_cmd_valid;
  wire       [31:0]   IBusCachedPlugin_cache_io_mem_cmd_payload_address;
  wire       [2:0]    IBusCachedPlugin_cache_io_mem_cmd_payload_size;
  wire                dataCache_1_io_cpu_execute_haltIt;
  wire                dataCache_1_io_cpu_execute_refilling;
  wire                dataCache_1_io_cpu_memory_isWrite;
  wire                dataCache_1_io_cpu_writeBack_haltIt;
  wire       [31:0]   dataCache_1_io_cpu_writeBack_data;
  wire                dataCache_1_io_cpu_writeBack_mmuException;
  wire                dataCache_1_io_cpu_writeBack_unalignedAccess;
  wire                dataCache_1_io_cpu_writeBack_accessError;
  wire                dataCache_1_io_cpu_writeBack_isWrite;
  wire                dataCache_1_io_cpu_writeBack_keepMemRspData;
  wire                dataCache_1_io_cpu_writeBack_exclusiveOk;
  wire                dataCache_1_io_cpu_flush_ready;
  wire                dataCache_1_io_cpu_redo;
  wire                dataCache_1_io_cpu_writesPending;
  wire                dataCache_1_io_mem_cmd_valid;
  wire                dataCache_1_io_mem_cmd_payload_wr;
  wire                dataCache_1_io_mem_cmd_payload_uncached;
  wire       [31:0]   dataCache_1_io_mem_cmd_payload_address;
  wire       [31:0]   dataCache_1_io_mem_cmd_payload_data;
  wire       [3:0]    dataCache_1_io_mem_cmd_payload_mask;
  wire       [2:0]    dataCache_1_io_mem_cmd_payload_size;
  wire                dataCache_1_io_mem_cmd_payload_last;
  wire       [51:0]   _zz_memory_MUL_LOW;
  wire       [51:0]   _zz_memory_MUL_LOW_1;
  wire       [51:0]   _zz_memory_MUL_LOW_2;
  wire       [32:0]   _zz_memory_MUL_LOW_3;
  wire       [51:0]   _zz_memory_MUL_LOW_4;
  wire       [49:0]   _zz_memory_MUL_LOW_5;
  wire       [51:0]   _zz_memory_MUL_LOW_6;
  wire       [49:0]   _zz_memory_MUL_LOW_7;
  wire       [31:0]   _zz_execute_SHIFT_RIGHT;
  wire       [32:0]   _zz_execute_SHIFT_RIGHT_1;
  wire       [32:0]   _zz_execute_SHIFT_RIGHT_2;
  wire       [31:0]   _zz_decode_LEGAL_INSTRUCTION;
  wire       [31:0]   _zz_decode_LEGAL_INSTRUCTION_1;
  wire       [31:0]   _zz_decode_LEGAL_INSTRUCTION_2;
  wire                _zz_decode_LEGAL_INSTRUCTION_3;
  wire       [0:0]    _zz_decode_LEGAL_INSTRUCTION_4;
  wire       [11:0]   _zz_decode_LEGAL_INSTRUCTION_5;
  wire       [31:0]   _zz_decode_LEGAL_INSTRUCTION_6;
  wire       [31:0]   _zz_decode_LEGAL_INSTRUCTION_7;
  wire       [31:0]   _zz_decode_LEGAL_INSTRUCTION_8;
  wire                _zz_decode_LEGAL_INSTRUCTION_9;
  wire       [0:0]    _zz_decode_LEGAL_INSTRUCTION_10;
  wire       [5:0]    _zz_decode_LEGAL_INSTRUCTION_11;
  wire       [31:0]   _zz_decode_LEGAL_INSTRUCTION_12;
  wire       [31:0]   _zz_decode_LEGAL_INSTRUCTION_13;
  wire       [31:0]   _zz_decode_LEGAL_INSTRUCTION_14;
  wire                _zz_decode_LEGAL_INSTRUCTION_15;
  wire                _zz_decode_LEGAL_INSTRUCTION_16;
  wire       [2:0]    _zz__zz_IBusCachedPlugin_jump_pcLoad_payload_1;
  reg        [31:0]   _zz_IBusCachedPlugin_jump_pcLoad_payload_4;
  wire       [1:0]    _zz_IBusCachedPlugin_jump_pcLoad_payload_5;
  wire       [31:0]   _zz_IBusCachedPlugin_fetchPc_pc;
  wire       [2:0]    _zz_IBusCachedPlugin_fetchPc_pc_1;
  wire       [55:0]   _zz_IBusCachedPlugin_predictor_history_port;
  wire       [7:0]    _zz_IBusCachedPlugin_predictor_history_port_1;
  wire       [7:0]    _zz__zz_IBusCachedPlugin_predictor_buffer_line_source_1;
  wire       [7:0]    _zz_IBusCachedPlugin_predictor_buffer_hazard;
  wire       [29:0]   _zz_IBusCachedPlugin_predictor_buffer_hazard_1;
  wire       [21:0]   _zz_IBusCachedPlugin_predictor_hit;
  wire       [1:0]    _zz_IBusCachedPlugin_predictor_historyWrite_payload_data_branchWish;
  wire       [1:0]    _zz_IBusCachedPlugin_predictor_historyWrite_payload_data_branchWish_1;
  wire       [0:0]    _zz_IBusCachedPlugin_predictor_historyWrite_payload_data_branchWish_2;
  wire       [1:0]    _zz_IBusCachedPlugin_predictor_historyWrite_payload_data_branchWish_3;
  wire       [0:0]    _zz_IBusCachedPlugin_predictor_historyWrite_payload_data_branchWish_4;
  wire       [1:0]    _zz_IBusCachedPlugin_predictor_historyWrite_payload_data_branchWish_5;
  wire       [1:0]    _zz_IBusCachedPlugin_predictor_historyWrite_payload_data_branchWish_6;
  wire       [0:0]    _zz_IBusCachedPlugin_predictor_historyWrite_payload_data_branchWish_7;
  wire       [1:0]    _zz_IBusCachedPlugin_predictor_historyWrite_payload_data_branchWish_8;
  wire       [0:0]    _zz_IBusCachedPlugin_predictor_historyWrite_payload_data_branchWish_9;
  wire       [26:0]   _zz_io_cpu_flush_payload_lineId;
  wire       [26:0]   _zz_io_cpu_flush_payload_lineId_1;
  wire       [2:0]    _zz_DBusCachedPlugin_exceptionBus_payload_code;
  wire       [2:0]    _zz_DBusCachedPlugin_exceptionBus_payload_code_1;
  reg        [7:0]    _zz_writeBack_DBusCachedPlugin_rspShifted;
  wire       [1:0]    _zz_writeBack_DBusCachedPlugin_rspShifted_1;
  reg        [7:0]    _zz_writeBack_DBusCachedPlugin_rspShifted_2;
  wire       [0:0]    _zz_writeBack_DBusCachedPlugin_rspShifted_3;
  wire       [1:0]    _zz__zz_CsrPlugin_exceptionPortCtrl_exceptionContext_code_1;
  wire       [1:0]    _zz__zz_CsrPlugin_exceptionPortCtrl_exceptionContext_code_1_1;
  wire                _zz_when;
  wire       [31:0]   _zz__zz_decode_IS_RS2_SIGNED;
  wire       [31:0]   _zz__zz_decode_IS_RS2_SIGNED_1;
  wire       [31:0]   _zz__zz_decode_IS_RS2_SIGNED_2;
  wire       [31:0]   _zz__zz_decode_IS_RS2_SIGNED_3;
  wire       [0:0]    _zz__zz_decode_IS_RS2_SIGNED_4;
  wire                _zz__zz_decode_IS_RS2_SIGNED_5;
  wire       [0:0]    _zz__zz_decode_IS_RS2_SIGNED_6;
  wire       [31:0]   _zz__zz_decode_IS_RS2_SIGNED_7;
  wire       [24:0]   _zz__zz_decode_IS_RS2_SIGNED_8;
  wire       [31:0]   _zz__zz_decode_IS_RS2_SIGNED_9;
  wire       [31:0]   _zz__zz_decode_IS_RS2_SIGNED_10;
  wire       [0:0]    _zz__zz_decode_IS_RS2_SIGNED_11;
  wire       [0:0]    _zz__zz_decode_IS_RS2_SIGNED_12;
  wire       [0:0]    _zz__zz_decode_IS_RS2_SIGNED_13;
  wire                _zz__zz_decode_IS_RS2_SIGNED_14;
  wire       [31:0]   _zz__zz_decode_IS_RS2_SIGNED_15;
  wire       [0:0]    _zz__zz_decode_IS_RS2_SIGNED_16;
  wire       [31:0]   _zz__zz_decode_IS_RS2_SIGNED_17;
  wire       [31:0]   _zz__zz_decode_IS_RS2_SIGNED_18;
  wire       [19:0]   _zz__zz_decode_IS_RS2_SIGNED_19;
  wire       [0:0]    _zz__zz_decode_IS_RS2_SIGNED_20;
  wire       [0:0]    _zz__zz_decode_IS_RS2_SIGNED_21;
  wire       [0:0]    _zz__zz_decode_IS_RS2_SIGNED_22;
  wire                _zz__zz_decode_IS_RS2_SIGNED_23;
  wire       [31:0]   _zz__zz_decode_IS_RS2_SIGNED_24;
  wire       [31:0]   _zz__zz_decode_IS_RS2_SIGNED_25;
  wire       [31:0]   _zz__zz_decode_IS_RS2_SIGNED_26;
  wire       [31:0]   _zz__zz_decode_IS_RS2_SIGNED_27;
  wire       [0:0]    _zz__zz_decode_IS_RS2_SIGNED_28;
  wire       [31:0]   _zz__zz_decode_IS_RS2_SIGNED_29;
  wire       [31:0]   _zz__zz_decode_IS_RS2_SIGNED_30;
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
  wire       [0:0]    _zz__zz_decode_IS_RS2_SIGNED_107;
  wire       [31:0]   _zz__zz_decode_IS_RS2_SIGNED_108;
  wire       [0:0]    _zz__zz_decode_IS_RS2_SIGNED_109;
  wire       [1:0]    _zz__zz_decode_IS_RS2_SIGNED_110;
  wire       [1:0]    _zz__zz_decode_IS_RS2_SIGNED_111;
  wire       [31:0]   _zz__zz_decode_IS_RS2_SIGNED_112;
  wire       [31:0]   _zz__zz_decode_IS_RS2_SIGNED_113;
  wire       [0:0]    _zz__zz_decode_IS_RS2_SIGNED_114;
  wire       [31:0]   _zz__zz_decode_IS_RS2_SIGNED_115;
  wire       [0:0]    _zz__zz_execute_REGFILE_WRITE_DATA;
  wire       [2:0]    _zz__zz_execute_SRC1;
  wire       [4:0]    _zz__zz_execute_SRC1_1;
  wire       [11:0]   _zz__zz_execute_SRC2_2;
  wire       [31:0]   _zz_execute_SrcPlugin_addSub;
  wire       [31:0]   _zz_execute_SrcPlugin_addSub_1;
  wire       [31:0]   _zz_execute_SrcPlugin_addSub_2;
  wire       [31:0]   _zz_execute_SrcPlugin_addSub_3;
  wire       [31:0]   _zz_execute_SrcPlugin_addSub_4;
  wire       [65:0]   _zz_writeBack_MulPlugin_result;
  wire       [65:0]   _zz_writeBack_MulPlugin_result_1;
  wire       [31:0]   _zz__zz_decode_RS2_2;
  wire       [31:0]   _zz__zz_decode_RS2_2_1;
  wire       [5:0]    _zz_memory_DivPlugin_div_counter_valueNext;
  wire       [0:0]    _zz_memory_DivPlugin_div_counter_valueNext_1;
  wire       [32:0]   _zz_memory_DivPlugin_div_stage_0_remainderMinusDenominator;
  wire       [31:0]   _zz_memory_DivPlugin_div_stage_0_outRemainder;
  wire       [31:0]   _zz_memory_DivPlugin_div_stage_0_outRemainder_1;
  wire       [32:0]   _zz_memory_DivPlugin_div_stage_0_outNumerator;
  wire       [32:0]   _zz_memory_DivPlugin_div_result_1;
  wire       [32:0]   _zz_memory_DivPlugin_div_result_2;
  wire       [32:0]   _zz_memory_DivPlugin_div_result_3;
  wire       [32:0]   _zz_memory_DivPlugin_div_result_4;
  wire       [0:0]    _zz_memory_DivPlugin_div_result_5;
  wire       [32:0]   _zz_memory_DivPlugin_rs1_2;
  wire       [0:0]    _zz_memory_DivPlugin_rs1_3;
  wire       [31:0]   _zz_memory_DivPlugin_rs2_1;
  wire       [0:0]    _zz_memory_DivPlugin_rs2_2;
  wire       [19:0]   _zz__zz_execute_BRANCH_SRC22;
  wire       [11:0]   _zz__zz_execute_BRANCH_SRC22_4;
  wire       [51:0]   memory_MUL_LOW;
  wire                execute_TARGET_MISSMATCH2;
  wire       [31:0]   execute_NEXT_PC2;
  wire                execute_BRANCH_DO;
  wire       [33:0]   memory_MUL_HH;
  wire       [33:0]   execute_MUL_HH;
  wire       [33:0]   execute_MUL_HL;
  wire       [33:0]   execute_MUL_LH;
  wire       [31:0]   execute_MUL_LL;
  wire       [31:0]   execute_REGFILE_WRITE_DATA;
  wire       [31:0]   memory_MEMORY_STORE_DATA_RF;
  wire       [31:0]   execute_MEMORY_STORE_DATA_RF;
  wire                decode_DO_EBREAK;
  wire                decode_SRC2_FORCE_ZERO;
  wire       [1:0]    decode_BRANCH_CTRL;
  wire       [1:0]    _zz_decode_BRANCH_CTRL;
  wire       [1:0]    _zz_decode_to_execute_BRANCH_CTRL;
  wire       [1:0]    _zz_decode_to_execute_BRANCH_CTRL_1;
  wire                decode_IS_RS2_SIGNED;
  wire                decode_IS_RS1_SIGNED;
  wire                decode_IS_DIV;
  wire                memory_IS_MUL;
  wire                execute_IS_MUL;
  wire                decode_IS_MUL;
  wire       [1:0]    decode_SHIFT_CTRL;
  wire       [1:0]    _zz_decode_SHIFT_CTRL;
  wire       [1:0]    _zz_decode_to_execute_SHIFT_CTRL;
  wire       [1:0]    _zz_decode_to_execute_SHIFT_CTRL_1;
  wire       [1:0]    decode_ALU_BITWISE_CTRL;
  wire       [1:0]    _zz_decode_ALU_BITWISE_CTRL;
  wire       [1:0]    _zz_decode_to_execute_ALU_BITWISE_CTRL;
  wire       [1:0]    _zz_decode_to_execute_ALU_BITWISE_CTRL_1;
  wire                decode_SRC_LESS_UNSIGNED;
  wire       [0:0]    _zz_memory_to_writeBack_ENV_CTRL;
  wire       [0:0]    _zz_memory_to_writeBack_ENV_CTRL_1;
  wire       [0:0]    _zz_execute_to_memory_ENV_CTRL;
  wire       [0:0]    _zz_execute_to_memory_ENV_CTRL_1;
  wire       [0:0]    decode_ENV_CTRL;
  wire       [0:0]    _zz_decode_ENV_CTRL;
  wire       [0:0]    _zz_decode_to_execute_ENV_CTRL;
  wire       [0:0]    _zz_decode_to_execute_ENV_CTRL_1;
  wire                decode_IS_CSR;
  wire                decode_MEMORY_MANAGMENT;
  wire                memory_MEMORY_WR;
  wire                decode_MEMORY_WR;
  wire                execute_BYPASSABLE_MEMORY_STAGE;
  wire                decode_BYPASSABLE_MEMORY_STAGE;
  wire                decode_BYPASSABLE_EXECUTE_STAGE;
  wire       [1:0]    decode_SRC2_CTRL;
  wire       [1:0]    _zz_decode_SRC2_CTRL;
  wire       [1:0]    _zz_decode_to_execute_SRC2_CTRL;
  wire       [1:0]    _zz_decode_to_execute_SRC2_CTRL_1;
  wire       [1:0]    decode_ALU_CTRL;
  wire       [1:0]    _zz_decode_ALU_CTRL;
  wire       [1:0]    _zz_decode_to_execute_ALU_CTRL;
  wire       [1:0]    _zz_decode_to_execute_ALU_CTRL_1;
  wire       [1:0]    decode_SRC1_CTRL;
  wire       [1:0]    _zz_decode_SRC1_CTRL;
  wire       [1:0]    _zz_decode_to_execute_SRC1_CTRL;
  wire       [1:0]    _zz_decode_to_execute_SRC1_CTRL_1;
  wire                decode_CSR_READ_OPCODE;
  wire                decode_CSR_WRITE_OPCODE;
  wire                decode_MEMORY_FORCE_CONSTISTENCY;
  wire                execute_PREDICTION_CONTEXT_hazard;
  wire                execute_PREDICTION_CONTEXT_hit;
  wire       [21:0]   execute_PREDICTION_CONTEXT_line_source;
  wire       [1:0]    execute_PREDICTION_CONTEXT_line_branchWish;
  wire       [31:0]   execute_PREDICTION_CONTEXT_line_target;
  wire                decode_PREDICTION_CONTEXT_hazard;
  wire                decode_PREDICTION_CONTEXT_hit;
  wire       [21:0]   decode_PREDICTION_CONTEXT_line_source;
  wire       [1:0]    decode_PREDICTION_CONTEXT_line_branchWish;
  wire       [31:0]   decode_PREDICTION_CONTEXT_line_target;
  wire       [31:0]   writeBack_FORMAL_PC_NEXT;
  wire       [31:0]   memory_FORMAL_PC_NEXT;
  wire       [31:0]   execute_FORMAL_PC_NEXT;
  wire       [31:0]   decode_FORMAL_PC_NEXT;
  wire                execute_DO_EBREAK;
  wire                decode_IS_EBREAK;
  wire       [31:0]   memory_NEXT_PC2;
  wire       [31:0]   memory_PC;
  wire       [31:0]   memory_BRANCH_CALC;
  wire                memory_TARGET_MISSMATCH2;
  wire                memory_BRANCH_DO;
  wire       [31:0]   execute_BRANCH_CALC;
  wire       [31:0]   execute_BRANCH_SRC22;
  wire       [31:0]   execute_PC;
  wire       [1:0]    execute_BRANCH_CTRL;
  wire       [1:0]    _zz_execute_BRANCH_CTRL;
  wire                execute_IS_RS1_SIGNED;
  wire                execute_IS_DIV;
  wire                execute_IS_RS2_SIGNED;
  wire                memory_IS_DIV;
  wire                writeBack_IS_MUL;
  wire       [33:0]   writeBack_MUL_HH;
  wire       [51:0]   writeBack_MUL_LOW;
  wire       [33:0]   memory_MUL_HL;
  wire       [33:0]   memory_MUL_LH;
  wire       [31:0]   memory_MUL_LL;
  wire                decode_RS2_USE;
  wire                decode_RS1_USE;
  wire                execute_REGFILE_WRITE_VALID;
  wire                execute_BYPASSABLE_EXECUTE_STAGE;
  reg        [31:0]   _zz_decode_RS2;
  wire                memory_REGFILE_WRITE_VALID;
  wire       [31:0]   memory_INSTRUCTION;
  wire                memory_BYPASSABLE_MEMORY_STAGE;
  wire                writeBack_REGFILE_WRITE_VALID;
  reg        [31:0]   decode_RS2;
  reg        [31:0]   decode_RS1;
  wire       [31:0]   execute_SHIFT_RIGHT;
  wire       [1:0]    execute_SHIFT_CTRL;
  wire       [1:0]    _zz_execute_SHIFT_CTRL;
  wire                execute_SRC_LESS_UNSIGNED;
  wire                execute_SRC2_FORCE_ZERO;
  wire                execute_SRC_USE_SUB_LESS;
  wire       [31:0]   _zz_execute_to_memory_PC;
  wire       [1:0]    execute_SRC2_CTRL;
  wire       [1:0]    _zz_execute_SRC2_CTRL;
  wire       [1:0]    execute_SRC1_CTRL;
  wire       [1:0]    _zz_execute_SRC1_CTRL;
  wire                decode_SRC_USE_SUB_LESS;
  wire                decode_SRC_ADD_ZERO;
  wire       [31:0]   execute_SRC_ADD_SUB;
  wire                execute_SRC_LESS;
  wire       [1:0]    execute_ALU_CTRL;
  wire       [1:0]    _zz_execute_ALU_CTRL;
  wire       [31:0]   execute_SRC2;
  wire       [1:0]    execute_ALU_BITWISE_CTRL;
  wire       [1:0]    _zz_execute_ALU_BITWISE_CTRL;
  wire       [31:0]   _zz_lastStageRegFileWrite_payload_address;
  wire                _zz_lastStageRegFileWrite_valid;
  reg                 _zz_1;
  reg                 decode_REGFILE_WRITE_VALID;
  wire                decode_LEGAL_INSTRUCTION;
  wire       [1:0]    _zz_decode_BRANCH_CTRL_1;
  wire       [1:0]    _zz_decode_SHIFT_CTRL_1;
  wire       [1:0]    _zz_decode_ALU_BITWISE_CTRL_1;
  wire       [0:0]    _zz_decode_ENV_CTRL_1;
  wire       [1:0]    _zz_decode_SRC2_CTRL_1;
  wire       [1:0]    _zz_decode_ALU_CTRL_1;
  wire       [1:0]    _zz_decode_SRC1_CTRL_1;
  reg        [31:0]   _zz_decode_RS2_1;
  wire       [31:0]   execute_SRC1;
  wire                execute_CSR_READ_OPCODE;
  wire                execute_CSR_WRITE_OPCODE;
  wire                execute_IS_CSR;
  wire       [0:0]    memory_ENV_CTRL;
  wire       [0:0]    _zz_memory_ENV_CTRL;
  wire       [0:0]    execute_ENV_CTRL;
  wire       [0:0]    _zz_execute_ENV_CTRL;
  wire       [0:0]    writeBack_ENV_CTRL;
  wire       [0:0]    _zz_writeBack_ENV_CTRL;
  reg        [31:0]   _zz_decode_RS2_2;
  wire                writeBack_MEMORY_WR;
  wire       [31:0]   writeBack_MEMORY_STORE_DATA_RF;
  wire       [31:0]   writeBack_REGFILE_WRITE_DATA;
  wire                writeBack_MEMORY_ENABLE;
  wire       [31:0]   memory_REGFILE_WRITE_DATA;
  wire                memory_MEMORY_ENABLE;
  wire                execute_MEMORY_FORCE_CONSTISTENCY;
  (* keep , syn_keep *) wire       [31:0]   execute_RS1 /* synthesis syn_keep = 1 */ ;
  wire                execute_MEMORY_MANAGMENT;
  (* keep , syn_keep *) wire       [31:0]   execute_RS2 /* synthesis syn_keep = 1 */ ;
  wire                execute_MEMORY_WR;
  wire       [31:0]   execute_SRC_ADD;
  wire                execute_MEMORY_ENABLE;
  wire       [31:0]   execute_INSTRUCTION;
  wire                decode_MEMORY_ENABLE;
  wire                decode_FLUSH_ALL;
  reg                 IBusCachedPlugin_rsp_issueDetected_4;
  reg                 IBusCachedPlugin_rsp_issueDetected_3;
  reg                 IBusCachedPlugin_rsp_issueDetected_2;
  reg                 IBusCachedPlugin_rsp_issueDetected_1;
  wire       [31:0]   decode_INSTRUCTION;
  wire                memory_PREDICTION_CONTEXT_hazard;
  wire                memory_PREDICTION_CONTEXT_hit;
  wire       [21:0]   memory_PREDICTION_CONTEXT_line_source;
  wire       [1:0]    memory_PREDICTION_CONTEXT_line_branchWish;
  wire       [31:0]   memory_PREDICTION_CONTEXT_line_target;
  reg                 _zz_2;
  reg        [31:0]   _zz_memory_to_writeBack_FORMAL_PC_NEXT;
  wire       [31:0]   decode_PC;
  wire       [31:0]   writeBack_PC;
  wire       [31:0]   writeBack_INSTRUCTION;
  reg                 decode_arbitration_haltItself;
  reg                 decode_arbitration_haltByOther;
  reg                 decode_arbitration_removeIt;
  wire                decode_arbitration_flushIt;
  reg                 decode_arbitration_flushNext;
  reg                 decode_arbitration_isValid;
  wire                decode_arbitration_isStuck;
  wire                decode_arbitration_isStuckByOthers;
  wire                decode_arbitration_isFlushed;
  wire                decode_arbitration_isMoving;
  wire                decode_arbitration_isFiring;
  reg                 execute_arbitration_haltItself;
  reg                 execute_arbitration_haltByOther;
  reg                 execute_arbitration_removeIt;
  reg                 execute_arbitration_flushIt;
  reg                 execute_arbitration_flushNext;
  reg                 execute_arbitration_isValid;
  wire                execute_arbitration_isStuck;
  wire                execute_arbitration_isStuckByOthers;
  wire                execute_arbitration_isFlushed;
  wire                execute_arbitration_isMoving;
  wire                execute_arbitration_isFiring;
  reg                 memory_arbitration_haltItself;
  wire                memory_arbitration_haltByOther;
  reg                 memory_arbitration_removeIt;
  wire                memory_arbitration_flushIt;
  reg                 memory_arbitration_flushNext;
  reg                 memory_arbitration_isValid;
  wire                memory_arbitration_isStuck;
  wire                memory_arbitration_isStuckByOthers;
  wire                memory_arbitration_isFlushed;
  wire                memory_arbitration_isMoving;
  wire                memory_arbitration_isFiring;
  reg                 writeBack_arbitration_haltItself;
  wire                writeBack_arbitration_haltByOther;
  reg                 writeBack_arbitration_removeIt;
  reg                 writeBack_arbitration_flushIt;
  reg                 writeBack_arbitration_flushNext;
  reg                 writeBack_arbitration_isValid;
  wire                writeBack_arbitration_isStuck;
  wire                writeBack_arbitration_isStuckByOthers;
  wire                writeBack_arbitration_isFlushed;
  wire                writeBack_arbitration_isMoving;
  wire                writeBack_arbitration_isFiring;
  wire       [31:0]   lastStageInstruction /* verilator public */ ;
  wire       [31:0]   lastStagePc /* verilator public */ ;
  wire                lastStageIsValid /* verilator public */ ;
  wire                lastStageIsFiring /* verilator public */ ;
  reg                 IBusCachedPlugin_fetcherHalt;
  wire                IBusCachedPlugin_forceNoDecodeCond;
  reg                 IBusCachedPlugin_incomingInstruction;
  wire                IBusCachedPlugin_fetchPrediction_cmd_hadBranch;
  wire       [31:0]   IBusCachedPlugin_fetchPrediction_cmd_targetPc;
  wire                IBusCachedPlugin_fetchPrediction_rsp_wasRight;
  wire       [31:0]   IBusCachedPlugin_fetchPrediction_rsp_finalPc;
  wire       [31:0]   IBusCachedPlugin_fetchPrediction_rsp_sourceLastWord;
  wire                IBusCachedPlugin_pcValids_0;
  wire                IBusCachedPlugin_pcValids_1;
  wire                IBusCachedPlugin_pcValids_2;
  wire                IBusCachedPlugin_pcValids_3;
  reg                 IBusCachedPlugin_decodeExceptionPort_valid;
  reg        [3:0]    IBusCachedPlugin_decodeExceptionPort_payload_code;
  wire       [31:0]   IBusCachedPlugin_decodeExceptionPort_payload_badAddr;
  wire                IBusCachedPlugin_mmuBus_cmd_0_isValid;
  wire                IBusCachedPlugin_mmuBus_cmd_0_isStuck;
  wire       [31:0]   IBusCachedPlugin_mmuBus_cmd_0_virtualAddress;
  wire                IBusCachedPlugin_mmuBus_cmd_0_bypassTranslation;
  wire       [31:0]   IBusCachedPlugin_mmuBus_rsp_physicalAddress;
  wire                IBusCachedPlugin_mmuBus_rsp_isIoAccess;
  wire                IBusCachedPlugin_mmuBus_rsp_isPaging;
  wire                IBusCachedPlugin_mmuBus_rsp_allowRead;
  wire                IBusCachedPlugin_mmuBus_rsp_allowWrite;
  wire                IBusCachedPlugin_mmuBus_rsp_allowExecute;
  wire                IBusCachedPlugin_mmuBus_rsp_exception;
  wire                IBusCachedPlugin_mmuBus_rsp_refilling;
  wire                IBusCachedPlugin_mmuBus_rsp_bypassTranslation;
  wire                IBusCachedPlugin_mmuBus_end;
  wire                IBusCachedPlugin_mmuBus_busy;
  wire                DBusCachedPlugin_mmuBus_cmd_0_isValid;
  wire                DBusCachedPlugin_mmuBus_cmd_0_isStuck;
  wire       [31:0]   DBusCachedPlugin_mmuBus_cmd_0_virtualAddress;
  wire                DBusCachedPlugin_mmuBus_cmd_0_bypassTranslation;
  wire       [31:0]   DBusCachedPlugin_mmuBus_rsp_physicalAddress;
  wire                DBusCachedPlugin_mmuBus_rsp_isIoAccess;
  wire                DBusCachedPlugin_mmuBus_rsp_isPaging;
  wire                DBusCachedPlugin_mmuBus_rsp_allowRead;
  wire                DBusCachedPlugin_mmuBus_rsp_allowWrite;
  wire                DBusCachedPlugin_mmuBus_rsp_allowExecute;
  wire                DBusCachedPlugin_mmuBus_rsp_exception;
  wire                DBusCachedPlugin_mmuBus_rsp_refilling;
  wire                DBusCachedPlugin_mmuBus_rsp_bypassTranslation;
  wire                DBusCachedPlugin_mmuBus_end;
  wire                DBusCachedPlugin_mmuBus_busy;
  reg                 DBusCachedPlugin_redoBranch_valid;
  wire       [31:0]   DBusCachedPlugin_redoBranch_payload;
  reg                 DBusCachedPlugin_exceptionBus_valid;
  reg        [3:0]    DBusCachedPlugin_exceptionBus_payload_code;
  wire       [31:0]   DBusCachedPlugin_exceptionBus_payload_badAddr;
  reg                 _zz_when_DBusCachedPlugin_l463;
  wire       [31:0]   CsrPlugin_csrMapping_readDataSignal;
  wire       [31:0]   CsrPlugin_csrMapping_readDataInit;
  wire       [31:0]   CsrPlugin_csrMapping_writeDataSignal;
  reg                 CsrPlugin_csrMapping_allowCsrSignal;
  wire                CsrPlugin_csrMapping_hazardFree;
  wire                CsrPlugin_csrMapping_doForceFailCsr;
  wire                CsrPlugin_inWfi /* verilator public */ ;
  reg                 CsrPlugin_thirdPartyWake;
  reg                 CsrPlugin_jumpInterface_valid;
  reg        [31:0]   CsrPlugin_jumpInterface_payload;
  wire                CsrPlugin_exceptionPendings_0;
  wire                CsrPlugin_exceptionPendings_1;
  wire                CsrPlugin_exceptionPendings_2;
  wire                CsrPlugin_exceptionPendings_3;
  wire                contextSwitching;
  reg        [1:0]    CsrPlugin_privilege;
  reg                 CsrPlugin_forceMachineWire;
  reg                 CsrPlugin_allowInterrupts;
  reg                 CsrPlugin_allowException;
  reg                 CsrPlugin_allowEbreakException;
  wire                CsrPlugin_xretAwayFromMachine;
  wire                decodeExceptionPort_valid;
  wire       [3:0]    decodeExceptionPort_payload_code;
  wire       [31:0]   decodeExceptionPort_payload_badAddr;
  wire                BranchPlugin_jumpInterface_valid;
  wire       [31:0]   BranchPlugin_jumpInterface_payload;
  wire                BranchPlugin_branchExceptionPort_valid;
  wire       [3:0]    BranchPlugin_branchExceptionPort_payload_code;
  wire       [31:0]   BranchPlugin_branchExceptionPort_payload_badAddr;
  reg                 BranchPlugin_inDebugNoFetchFlag;
  reg                 DebugPlugin_injectionPort_valid;
  reg                 DebugPlugin_injectionPort_ready;
  wire       [31:0]   DebugPlugin_injectionPort_payload;
  wire                IBusCachedPlugin_externalFlush;
  wire                IBusCachedPlugin_jump_pcLoad_valid;
  wire       [31:0]   IBusCachedPlugin_jump_pcLoad_payload;
  wire       [2:0]    _zz_IBusCachedPlugin_jump_pcLoad_payload;
  wire       [2:0]    _zz_IBusCachedPlugin_jump_pcLoad_payload_1;
  wire                _zz_IBusCachedPlugin_jump_pcLoad_payload_2;
  wire                _zz_IBusCachedPlugin_jump_pcLoad_payload_3;
  wire                IBusCachedPlugin_fetchPc_output_valid;
  wire                IBusCachedPlugin_fetchPc_output_ready;
  wire       [31:0]   IBusCachedPlugin_fetchPc_output_payload;
  reg        [31:0]   IBusCachedPlugin_fetchPc_pcReg /* verilator public */ ;
  reg                 IBusCachedPlugin_fetchPc_correction;
  reg                 IBusCachedPlugin_fetchPc_correctionReg;
  wire                IBusCachedPlugin_fetchPc_output_fire;
  wire                IBusCachedPlugin_fetchPc_corrected;
  wire                IBusCachedPlugin_fetchPc_pcRegPropagate;
  reg                 IBusCachedPlugin_fetchPc_booted;
  reg                 IBusCachedPlugin_fetchPc_inc;
  wire                when_Fetcher_l133;
  wire                when_Fetcher_l133_1;
  reg        [31:0]   IBusCachedPlugin_fetchPc_pc;
  wire                IBusCachedPlugin_fetchPc_predictionPcLoad_valid;
  wire       [31:0]   IBusCachedPlugin_fetchPc_predictionPcLoad_payload;
  wire                IBusCachedPlugin_fetchPc_redo_valid;
  wire       [31:0]   IBusCachedPlugin_fetchPc_redo_payload;
  reg                 IBusCachedPlugin_fetchPc_flushed;
  wire                when_Fetcher_l160;
  reg                 IBusCachedPlugin_iBusRsp_redoFetch;
  wire                IBusCachedPlugin_iBusRsp_stages_0_input_valid;
  wire                IBusCachedPlugin_iBusRsp_stages_0_input_ready;
  wire       [31:0]   IBusCachedPlugin_iBusRsp_stages_0_input_payload;
  wire                IBusCachedPlugin_iBusRsp_stages_0_output_valid;
  wire                IBusCachedPlugin_iBusRsp_stages_0_output_ready;
  wire       [31:0]   IBusCachedPlugin_iBusRsp_stages_0_output_payload;
  reg                 IBusCachedPlugin_iBusRsp_stages_0_halt;
  wire                IBusCachedPlugin_iBusRsp_stages_1_input_valid;
  wire                IBusCachedPlugin_iBusRsp_stages_1_input_ready;
  wire       [31:0]   IBusCachedPlugin_iBusRsp_stages_1_input_payload;
  wire                IBusCachedPlugin_iBusRsp_stages_1_output_valid;
  wire                IBusCachedPlugin_iBusRsp_stages_1_output_ready;
  wire       [31:0]   IBusCachedPlugin_iBusRsp_stages_1_output_payload;
  reg                 IBusCachedPlugin_iBusRsp_stages_1_halt;
  wire                IBusCachedPlugin_iBusRsp_stages_2_input_valid;
  wire                IBusCachedPlugin_iBusRsp_stages_2_input_ready;
  wire       [31:0]   IBusCachedPlugin_iBusRsp_stages_2_input_payload;
  wire                IBusCachedPlugin_iBusRsp_stages_2_output_valid;
  wire                IBusCachedPlugin_iBusRsp_stages_2_output_ready;
  wire       [31:0]   IBusCachedPlugin_iBusRsp_stages_2_output_payload;
  reg                 IBusCachedPlugin_iBusRsp_stages_2_halt;
  wire                _zz_IBusCachedPlugin_iBusRsp_stages_0_input_ready;
  wire                _zz_IBusCachedPlugin_iBusRsp_stages_1_input_ready;
  wire                _zz_IBusCachedPlugin_iBusRsp_stages_2_input_ready;
  wire                IBusCachedPlugin_iBusRsp_flush;
  wire                IBusCachedPlugin_iBusRsp_stages_0_output_m2sPipe_valid;
  wire                IBusCachedPlugin_iBusRsp_stages_0_output_m2sPipe_ready;
  wire       [31:0]   IBusCachedPlugin_iBusRsp_stages_0_output_m2sPipe_payload;
  reg                 _zz_IBusCachedPlugin_iBusRsp_stages_0_output_m2sPipe_valid;
  reg        [31:0]   _zz_IBusCachedPlugin_iBusRsp_stages_0_output_m2sPipe_payload;
  wire                IBusCachedPlugin_iBusRsp_stages_1_output_m2sPipe_valid;
  wire                IBusCachedPlugin_iBusRsp_stages_1_output_m2sPipe_ready;
  wire       [31:0]   IBusCachedPlugin_iBusRsp_stages_1_output_m2sPipe_payload;
  reg                 _zz_IBusCachedPlugin_iBusRsp_stages_1_output_m2sPipe_valid;
  reg        [31:0]   _zz_IBusCachedPlugin_iBusRsp_stages_1_output_m2sPipe_payload;
  reg                 IBusCachedPlugin_iBusRsp_readyForError;
  wire                IBusCachedPlugin_iBusRsp_output_valid;
  wire                IBusCachedPlugin_iBusRsp_output_ready;
  wire       [31:0]   IBusCachedPlugin_iBusRsp_output_payload_pc;
  wire                IBusCachedPlugin_iBusRsp_output_payload_rsp_error;
  wire       [31:0]   IBusCachedPlugin_iBusRsp_output_payload_rsp_inst;
  wire                IBusCachedPlugin_iBusRsp_output_payload_isRvc;
  wire                when_Fetcher_l242;
  wire                when_Fetcher_l322;
  reg                 IBusCachedPlugin_injector_nextPcCalc_valids_0;
  wire                when_Fetcher_l331;
  reg                 IBusCachedPlugin_injector_nextPcCalc_valids_1;
  wire                when_Fetcher_l331_1;
  reg                 IBusCachedPlugin_injector_nextPcCalc_valids_2;
  wire                when_Fetcher_l331_2;
  reg                 IBusCachedPlugin_injector_nextPcCalc_valids_3;
  wire                when_Fetcher_l331_3;
  reg                 IBusCachedPlugin_injector_nextPcCalc_valids_4;
  wire                when_Fetcher_l331_4;
  wire                IBusCachedPlugin_predictor_historyWriteDelayPatched_valid;
  wire       [7:0]    IBusCachedPlugin_predictor_historyWriteDelayPatched_payload_address;
  wire       [21:0]   IBusCachedPlugin_predictor_historyWriteDelayPatched_payload_data_source;
  wire       [1:0]    IBusCachedPlugin_predictor_historyWriteDelayPatched_payload_data_branchWish;
  wire       [31:0]   IBusCachedPlugin_predictor_historyWriteDelayPatched_payload_data_target;
  reg                 IBusCachedPlugin_predictor_historyWrite_valid;
  wire       [7:0]    IBusCachedPlugin_predictor_historyWrite_payload_address;
  wire       [21:0]   IBusCachedPlugin_predictor_historyWrite_payload_data_source;
  reg        [1:0]    IBusCachedPlugin_predictor_historyWrite_payload_data_branchWish;
  wire       [31:0]   IBusCachedPlugin_predictor_historyWrite_payload_data_target;
  reg                 IBusCachedPlugin_predictor_writeLast_valid;
  reg        [7:0]    IBusCachedPlugin_predictor_writeLast_payload_address;
  reg        [21:0]   IBusCachedPlugin_predictor_writeLast_payload_data_source;
  reg        [1:0]    IBusCachedPlugin_predictor_writeLast_payload_data_branchWish;
  reg        [31:0]   IBusCachedPlugin_predictor_writeLast_payload_data_target;
  wire       [29:0]   _zz_IBusCachedPlugin_predictor_buffer_line_source;
  wire       [21:0]   IBusCachedPlugin_predictor_buffer_line_source;
  wire       [1:0]    IBusCachedPlugin_predictor_buffer_line_branchWish;
  wire       [31:0]   IBusCachedPlugin_predictor_buffer_line_target;
  wire       [55:0]   _zz_IBusCachedPlugin_predictor_buffer_line_source_1;
  reg                 IBusCachedPlugin_predictor_buffer_pcCorrected;
  wire                IBusCachedPlugin_predictor_buffer_hazard;
  reg        [21:0]   IBusCachedPlugin_predictor_line_source;
  reg        [1:0]    IBusCachedPlugin_predictor_line_branchWish;
  reg        [31:0]   IBusCachedPlugin_predictor_line_target;
  reg                 IBusCachedPlugin_predictor_buffer_hazard_regNextWhen;
  wire                IBusCachedPlugin_predictor_hazard;
  wire                IBusCachedPlugin_predictor_hit;
  wire                IBusCachedPlugin_predictor_fetchContext_hazard;
  wire                IBusCachedPlugin_predictor_fetchContext_hit;
  wire       [21:0]   IBusCachedPlugin_predictor_fetchContext_line_source;
  wire       [1:0]    IBusCachedPlugin_predictor_fetchContext_line_branchWish;
  wire       [31:0]   IBusCachedPlugin_predictor_fetchContext_line_target;
  reg                 IBusCachedPlugin_predictor_iBusRspContext_hazard;
  reg                 IBusCachedPlugin_predictor_iBusRspContext_hit;
  reg        [21:0]   IBusCachedPlugin_predictor_iBusRspContext_line_source;
  reg        [1:0]    IBusCachedPlugin_predictor_iBusRspContext_line_branchWish;
  reg        [31:0]   IBusCachedPlugin_predictor_iBusRspContext_line_target;
  wire                IBusCachedPlugin_predictor_iBusRspContextOutput_hazard;
  wire                IBusCachedPlugin_predictor_iBusRspContextOutput_hit;
  wire       [21:0]   IBusCachedPlugin_predictor_iBusRspContextOutput_line_source;
  wire       [1:0]    IBusCachedPlugin_predictor_iBusRspContextOutput_line_branchWish;
  wire       [31:0]   IBusCachedPlugin_predictor_iBusRspContextOutput_line_target;
  wire                IBusCachedPlugin_predictor_injectorContext_hazard;
  wire                IBusCachedPlugin_predictor_injectorContext_hit;
  wire       [21:0]   IBusCachedPlugin_predictor_injectorContext_line_source;
  wire       [1:0]    IBusCachedPlugin_predictor_injectorContext_line_branchWish;
  wire       [31:0]   IBusCachedPlugin_predictor_injectorContext_line_target;
  wire                when_Fetcher_l619;
  reg        [31:0]   IBusCachedPlugin_rspCounter;
  wire                IBusCachedPlugin_s0_tightlyCoupledHit;
  reg                 IBusCachedPlugin_s1_tightlyCoupledHit;
  reg                 IBusCachedPlugin_s2_tightlyCoupledHit;
  wire                IBusCachedPlugin_rsp_iBusRspOutputHalt;
  wire                IBusCachedPlugin_rsp_issueDetected;
  reg                 IBusCachedPlugin_rsp_redoFetch;
  wire                when_IBusCachedPlugin_l245;
  wire                when_IBusCachedPlugin_l250;
  wire                when_IBusCachedPlugin_l256;
  wire                when_IBusCachedPlugin_l262;
  wire                when_IBusCachedPlugin_l273;
  reg        [31:0]   DBusCachedPlugin_rspCounter;
  wire                when_DBusCachedPlugin_l343;
  wire       [1:0]    execute_DBusCachedPlugin_size;
  reg        [31:0]   _zz_execute_MEMORY_STORE_DATA_RF;
  wire                system_cpu_dataCache_1_io_cpu_flush_isStall;
  wire                when_DBusCachedPlugin_l385;
  wire                when_DBusCachedPlugin_l401;
  wire                when_DBusCachedPlugin_l463;
  wire                when_DBusCachedPlugin_l524;
  wire                when_DBusCachedPlugin_l544;
  wire       [31:0]   writeBack_DBusCachedPlugin_rspData;
  wire       [7:0]    writeBack_DBusCachedPlugin_rspSplits_0;
  wire       [7:0]    writeBack_DBusCachedPlugin_rspSplits_1;
  wire       [7:0]    writeBack_DBusCachedPlugin_rspSplits_2;
  wire       [7:0]    writeBack_DBusCachedPlugin_rspSplits_3;
  reg        [31:0]   writeBack_DBusCachedPlugin_rspShifted;
  wire       [31:0]   writeBack_DBusCachedPlugin_rspRf;
  wire       [1:0]    switch_Misc_l227;
  wire                _zz_writeBack_DBusCachedPlugin_rspFormated;
  reg        [31:0]   _zz_writeBack_DBusCachedPlugin_rspFormated_1;
  wire                _zz_writeBack_DBusCachedPlugin_rspFormated_2;
  reg        [31:0]   _zz_writeBack_DBusCachedPlugin_rspFormated_3;
  reg        [31:0]   writeBack_DBusCachedPlugin_rspFormated;
  wire                when_DBusCachedPlugin_l571;
  wire       [1:0]    CsrPlugin_misa_base;
  wire       [25:0]   CsrPlugin_misa_extensions;
  wire       [1:0]    CsrPlugin_mtvec_mode;
  wire       [29:0]   CsrPlugin_mtvec_base;
  reg        [31:0]   CsrPlugin_mepc;
  reg                 CsrPlugin_mstatus_MIE;
  reg                 CsrPlugin_mstatus_MPIE;
  reg        [1:0]    CsrPlugin_mstatus_MPP;
  reg                 CsrPlugin_mip_MEIP;
  reg                 CsrPlugin_mip_MTIP;
  reg                 CsrPlugin_mip_MSIP;
  reg                 CsrPlugin_mie_MEIE;
  reg                 CsrPlugin_mie_MTIE;
  reg                 CsrPlugin_mie_MSIE;
  reg                 CsrPlugin_mcause_interrupt;
  reg        [3:0]    CsrPlugin_mcause_exceptionCode;
  reg        [31:0]   CsrPlugin_mtval;
  reg        [63:0]   CsrPlugin_mcycle;
  reg        [63:0]   CsrPlugin_minstret;
  wire                _zz_when_CsrPlugin_l1302;
  wire                _zz_when_CsrPlugin_l1302_1;
  wire                _zz_when_CsrPlugin_l1302_2;
  reg                 CsrPlugin_exceptionPortCtrl_exceptionValids_decode;
  reg                 CsrPlugin_exceptionPortCtrl_exceptionValids_execute;
  reg                 CsrPlugin_exceptionPortCtrl_exceptionValids_memory;
  reg                 CsrPlugin_exceptionPortCtrl_exceptionValids_writeBack;
  reg                 CsrPlugin_exceptionPortCtrl_exceptionValidsRegs_decode;
  reg                 CsrPlugin_exceptionPortCtrl_exceptionValidsRegs_execute;
  reg                 CsrPlugin_exceptionPortCtrl_exceptionValidsRegs_memory;
  reg                 CsrPlugin_exceptionPortCtrl_exceptionValidsRegs_writeBack;
  reg        [3:0]    CsrPlugin_exceptionPortCtrl_exceptionContext_code;
  reg        [31:0]   CsrPlugin_exceptionPortCtrl_exceptionContext_badAddr;
  wire       [1:0]    CsrPlugin_exceptionPortCtrl_exceptionTargetPrivilegeUncapped;
  wire       [1:0]    CsrPlugin_exceptionPortCtrl_exceptionTargetPrivilege;
  wire       [1:0]    _zz_CsrPlugin_exceptionPortCtrl_exceptionContext_code;
  wire                _zz_CsrPlugin_exceptionPortCtrl_exceptionContext_code_1;
  wire                when_CsrPlugin_l1259;
  wire                when_CsrPlugin_l1259_1;
  wire                when_CsrPlugin_l1259_2;
  wire                when_CsrPlugin_l1259_3;
  wire                when_CsrPlugin_l1272;
  reg                 CsrPlugin_interrupt_valid;
  reg        [3:0]    CsrPlugin_interrupt_code /* verilator public */ ;
  reg        [1:0]    CsrPlugin_interrupt_targetPrivilege;
  wire                when_CsrPlugin_l1296;
  wire                when_CsrPlugin_l1302;
  wire                when_CsrPlugin_l1302_1;
  wire                when_CsrPlugin_l1302_2;
  wire                CsrPlugin_exception;
  wire                CsrPlugin_lastStageWasWfi;
  reg                 CsrPlugin_pipelineLiberator_pcValids_0;
  reg                 CsrPlugin_pipelineLiberator_pcValids_1;
  reg                 CsrPlugin_pipelineLiberator_pcValids_2;
  wire                CsrPlugin_pipelineLiberator_active;
  wire                when_CsrPlugin_l1335;
  wire                when_CsrPlugin_l1335_1;
  wire                when_CsrPlugin_l1335_2;
  wire                when_CsrPlugin_l1340;
  reg                 CsrPlugin_pipelineLiberator_done;
  wire                when_CsrPlugin_l1346;
  wire                CsrPlugin_interruptJump /* verilator public */ ;
  reg                 CsrPlugin_hadException /* verilator public */ ;
  reg        [1:0]    CsrPlugin_targetPrivilege;
  reg        [3:0]    CsrPlugin_trapCause;
  wire                CsrPlugin_trapCauseEbreakDebug;
  reg        [1:0]    CsrPlugin_xtvec_mode;
  reg        [29:0]   CsrPlugin_xtvec_base;
  wire                CsrPlugin_trapEnterDebug;
  wire                when_CsrPlugin_l1390;
  wire                when_CsrPlugin_l1398;
  wire                when_CsrPlugin_l1456;
  wire       [1:0]    switch_CsrPlugin_l1460;
  reg                 execute_CsrPlugin_wfiWake;
  wire                when_CsrPlugin_l1527;
  wire                execute_CsrPlugin_blockedBySideEffects;
  reg                 execute_CsrPlugin_illegalAccess;
  reg                 execute_CsrPlugin_illegalInstruction;
  wire                when_CsrPlugin_l1547;
  wire                when_CsrPlugin_l1548;
  reg                 execute_CsrPlugin_writeInstruction;
  reg                 execute_CsrPlugin_readInstruction;
  wire                execute_CsrPlugin_writeEnable;
  wire                execute_CsrPlugin_readEnable;
  wire       [31:0]   execute_CsrPlugin_readToWriteData;
  wire                switch_Misc_l227_1;
  reg        [31:0]   _zz_CsrPlugin_csrMapping_writeDataSignal;
  wire                when_CsrPlugin_l1587;
  wire                when_CsrPlugin_l1591;
  wire       [11:0]   execute_CsrPlugin_csrAddress;
  wire       [31:0]   _zz_decode_IS_RS2_SIGNED;
  wire                _zz_decode_IS_RS2_SIGNED_1;
  wire                _zz_decode_IS_RS2_SIGNED_2;
  wire                _zz_decode_IS_RS2_SIGNED_3;
  wire                _zz_decode_IS_RS2_SIGNED_4;
  wire                _zz_decode_IS_RS2_SIGNED_5;
  wire                _zz_decode_IS_RS2_SIGNED_6;
  wire       [1:0]    _zz_decode_SRC1_CTRL_2;
  wire       [1:0]    _zz_decode_ALU_CTRL_2;
  wire       [1:0]    _zz_decode_SRC2_CTRL_2;
  wire       [0:0]    _zz_decode_ENV_CTRL_2;
  wire       [1:0]    _zz_decode_ALU_BITWISE_CTRL_2;
  wire       [1:0]    _zz_decode_SHIFT_CTRL_2;
  wire       [1:0]    _zz_decode_BRANCH_CTRL_2;
  wire                when_RegFilePlugin_l63;
  wire       [4:0]    decode_RegFilePlugin_regFileReadAddress1;
  wire       [4:0]    decode_RegFilePlugin_regFileReadAddress2;
  wire       [31:0]   decode_RegFilePlugin_rs1Data;
  wire       [31:0]   decode_RegFilePlugin_rs2Data;
  reg                 lastStageRegFileWrite_valid /* verilator public */ ;
  reg        [4:0]    lastStageRegFileWrite_payload_address /* verilator public */ ;
  reg        [31:0]   lastStageRegFileWrite_payload_data /* verilator public */ ;
  reg                 _zz_8;
  reg        [31:0]   execute_IntAluPlugin_bitwise;
  reg        [31:0]   _zz_execute_REGFILE_WRITE_DATA;
  reg        [31:0]   _zz_execute_SRC1;
  wire                _zz_execute_SRC2;
  reg        [19:0]   _zz_execute_SRC2_1;
  wire                _zz_execute_SRC2_2;
  reg        [19:0]   _zz_execute_SRC2_3;
  reg        [31:0]   _zz_execute_SRC2_4;
  reg        [31:0]   execute_SrcPlugin_addSub;
  wire                execute_SrcPlugin_less;
  wire       [4:0]    execute_FullBarrelShifterPlugin_amplitude;
  reg        [31:0]   _zz_execute_FullBarrelShifterPlugin_reversed;
  wire       [31:0]   execute_FullBarrelShifterPlugin_reversed;
  reg        [31:0]   _zz_decode_RS2_3;
  reg                 HazardSimplePlugin_src0Hazard;
  reg                 HazardSimplePlugin_src1Hazard;
  wire                HazardSimplePlugin_writeBackWrites_valid;
  wire       [4:0]    HazardSimplePlugin_writeBackWrites_payload_address;
  wire       [31:0]   HazardSimplePlugin_writeBackWrites_payload_data;
  reg                 HazardSimplePlugin_writeBackBuffer_valid;
  reg        [4:0]    HazardSimplePlugin_writeBackBuffer_payload_address;
  reg        [31:0]   HazardSimplePlugin_writeBackBuffer_payload_data;
  wire                HazardSimplePlugin_addr0Match;
  wire                HazardSimplePlugin_addr1Match;
  wire                when_HazardSimplePlugin_l47;
  wire                when_HazardSimplePlugin_l48;
  wire                when_HazardSimplePlugin_l51;
  wire                when_HazardSimplePlugin_l45;
  wire                when_HazardSimplePlugin_l57;
  wire                when_HazardSimplePlugin_l58;
  wire                when_HazardSimplePlugin_l48_1;
  wire                when_HazardSimplePlugin_l51_1;
  wire                when_HazardSimplePlugin_l45_1;
  wire                when_HazardSimplePlugin_l57_1;
  wire                when_HazardSimplePlugin_l58_1;
  wire                when_HazardSimplePlugin_l48_2;
  wire                when_HazardSimplePlugin_l51_2;
  wire                when_HazardSimplePlugin_l45_2;
  wire                when_HazardSimplePlugin_l57_2;
  wire                when_HazardSimplePlugin_l58_2;
  wire                when_HazardSimplePlugin_l105;
  wire                when_HazardSimplePlugin_l108;
  wire                when_HazardSimplePlugin_l113;
  reg                 execute_MulPlugin_aSigned;
  reg                 execute_MulPlugin_bSigned;
  wire       [31:0]   execute_MulPlugin_a;
  wire       [31:0]   execute_MulPlugin_b;
  wire       [1:0]    switch_MulPlugin_l87;
  wire       [15:0]   execute_MulPlugin_aULow;
  wire       [15:0]   execute_MulPlugin_bULow;
  wire       [16:0]   execute_MulPlugin_aSLow;
  wire       [16:0]   execute_MulPlugin_bSLow;
  wire       [16:0]   execute_MulPlugin_aHigh;
  wire       [16:0]   execute_MulPlugin_bHigh;
  wire       [65:0]   writeBack_MulPlugin_result;
  wire                when_MulPlugin_l147;
  wire       [1:0]    switch_MulPlugin_l148;
  reg        [32:0]   memory_DivPlugin_rs1;
  reg        [31:0]   memory_DivPlugin_rs2;
  reg        [64:0]   memory_DivPlugin_accumulator;
  wire                memory_DivPlugin_frontendOk;
  reg                 memory_DivPlugin_div_needRevert;
  reg                 memory_DivPlugin_div_counter_willIncrement;
  reg                 memory_DivPlugin_div_counter_willClear;
  reg        [5:0]    memory_DivPlugin_div_counter_valueNext;
  reg        [5:0]    memory_DivPlugin_div_counter_value;
  wire                memory_DivPlugin_div_counter_willOverflowIfInc;
  wire                memory_DivPlugin_div_counter_willOverflow;
  reg                 memory_DivPlugin_div_done;
  wire                when_MulDivIterativePlugin_l126;
  wire                when_MulDivIterativePlugin_l126_1;
  reg        [31:0]   memory_DivPlugin_div_result;
  wire                when_MulDivIterativePlugin_l128;
  wire                when_MulDivIterativePlugin_l129;
  wire                when_MulDivIterativePlugin_l132;
  wire       [31:0]   _zz_memory_DivPlugin_div_stage_0_remainderShifted;
  wire       [32:0]   memory_DivPlugin_div_stage_0_remainderShifted;
  wire       [32:0]   memory_DivPlugin_div_stage_0_remainderMinusDenominator;
  wire       [31:0]   memory_DivPlugin_div_stage_0_outRemainder;
  wire       [31:0]   memory_DivPlugin_div_stage_0_outNumerator;
  wire                when_MulDivIterativePlugin_l151;
  wire       [31:0]   _zz_memory_DivPlugin_div_result;
  wire                when_MulDivIterativePlugin_l162;
  wire                _zz_memory_DivPlugin_rs2;
  wire                _zz_memory_DivPlugin_rs1;
  reg        [32:0]   _zz_memory_DivPlugin_rs1_1;
  wire                execute_BranchPlugin_eq;
  wire       [2:0]    switch_Misc_l227_2;
  reg                 _zz_execute_BRANCH_DO;
  reg                 _zz_execute_BRANCH_DO_1;
  wire       [31:0]   execute_BranchPlugin_branch_src1;
  wire                _zz_execute_BRANCH_SRC22;
  reg        [10:0]   _zz_execute_BRANCH_SRC22_1;
  wire                _zz_execute_BRANCH_SRC22_2;
  reg        [19:0]   _zz_execute_BRANCH_SRC22_3;
  wire                _zz_execute_BRANCH_SRC22_4;
  reg        [18:0]   _zz_execute_BRANCH_SRC22_5;
  reg        [31:0]   _zz_execute_BRANCH_SRC22_6;
  wire       [31:0]   execute_BranchPlugin_branchAdder;
  reg                 memory_BranchPlugin_predictionMissmatch;
  reg                 DebugPlugin_firstCycle;
  reg                 DebugPlugin_secondCycle;
  reg                 DebugPlugin_resetIt;
  reg                 DebugPlugin_haltIt;
  reg                 DebugPlugin_stepIt;
  reg                 DebugPlugin_isPipBusy;
  reg                 DebugPlugin_godmode;
  wire                when_DebugPlugin_l238;
  reg                 DebugPlugin_haltedByBreak;
  reg                 DebugPlugin_debugUsed /* verilator public */ ;
  reg                 DebugPlugin_disableEbreak;
  wire                DebugPlugin_allowEBreak;
  reg        [31:0]   DebugPlugin_busReadDataReg;
  reg                 _zz_when_DebugPlugin_l257;
  wire                when_DebugPlugin_l257;
  wire       [5:0]    switch_DebugPlugin_l280;
  wire                when_DebugPlugin_l284;
  wire                when_DebugPlugin_l284_1;
  wire                when_DebugPlugin_l285;
  wire                when_DebugPlugin_l285_1;
  wire                when_DebugPlugin_l286;
  wire                when_DebugPlugin_l287;
  wire                when_DebugPlugin_l288;
  wire                when_DebugPlugin_l288_1;
  wire                when_DebugPlugin_l308;
  wire                when_DebugPlugin_l311;
  wire                when_DebugPlugin_l324;
  reg                 DebugPlugin_resetIt_regNext;
  wire                when_DebugPlugin_l344;
  wire                when_Pipeline_l124;
  reg        [31:0]   decode_to_execute_PC;
  wire                when_Pipeline_l124_1;
  reg        [31:0]   execute_to_memory_PC;
  wire                when_Pipeline_l124_2;
  reg        [31:0]   memory_to_writeBack_PC;
  wire                when_Pipeline_l124_3;
  reg        [31:0]   decode_to_execute_INSTRUCTION;
  wire                when_Pipeline_l124_4;
  reg        [31:0]   execute_to_memory_INSTRUCTION;
  wire                when_Pipeline_l124_5;
  reg        [31:0]   memory_to_writeBack_INSTRUCTION;
  wire                when_Pipeline_l124_6;
  reg        [31:0]   decode_to_execute_FORMAL_PC_NEXT;
  wire                when_Pipeline_l124_7;
  reg        [31:0]   execute_to_memory_FORMAL_PC_NEXT;
  wire                when_Pipeline_l124_8;
  reg        [31:0]   memory_to_writeBack_FORMAL_PC_NEXT;
  wire                when_Pipeline_l124_9;
  reg                 decode_to_execute_PREDICTION_CONTEXT_hazard;
  reg                 decode_to_execute_PREDICTION_CONTEXT_hit;
  reg        [21:0]   decode_to_execute_PREDICTION_CONTEXT_line_source;
  reg        [1:0]    decode_to_execute_PREDICTION_CONTEXT_line_branchWish;
  reg        [31:0]   decode_to_execute_PREDICTION_CONTEXT_line_target;
  wire                when_Pipeline_l124_10;
  reg                 execute_to_memory_PREDICTION_CONTEXT_hazard;
  reg                 execute_to_memory_PREDICTION_CONTEXT_hit;
  reg        [21:0]   execute_to_memory_PREDICTION_CONTEXT_line_source;
  reg        [1:0]    execute_to_memory_PREDICTION_CONTEXT_line_branchWish;
  reg        [31:0]   execute_to_memory_PREDICTION_CONTEXT_line_target;
  wire                when_Pipeline_l124_11;
  reg                 decode_to_execute_MEMORY_FORCE_CONSTISTENCY;
  wire                when_Pipeline_l124_12;
  reg                 decode_to_execute_CSR_WRITE_OPCODE;
  wire                when_Pipeline_l124_13;
  reg                 decode_to_execute_CSR_READ_OPCODE;
  wire                when_Pipeline_l124_14;
  reg        [1:0]    decode_to_execute_SRC1_CTRL;
  wire                when_Pipeline_l124_15;
  reg                 decode_to_execute_SRC_USE_SUB_LESS;
  wire                when_Pipeline_l124_16;
  reg                 decode_to_execute_MEMORY_ENABLE;
  wire                when_Pipeline_l124_17;
  reg                 execute_to_memory_MEMORY_ENABLE;
  wire                when_Pipeline_l124_18;
  reg                 memory_to_writeBack_MEMORY_ENABLE;
  wire                when_Pipeline_l124_19;
  reg        [1:0]    decode_to_execute_ALU_CTRL;
  wire                when_Pipeline_l124_20;
  reg        [1:0]    decode_to_execute_SRC2_CTRL;
  wire                when_Pipeline_l124_21;
  reg                 decode_to_execute_REGFILE_WRITE_VALID;
  wire                when_Pipeline_l124_22;
  reg                 execute_to_memory_REGFILE_WRITE_VALID;
  wire                when_Pipeline_l124_23;
  reg                 memory_to_writeBack_REGFILE_WRITE_VALID;
  wire                when_Pipeline_l124_24;
  reg                 decode_to_execute_BYPASSABLE_EXECUTE_STAGE;
  wire                when_Pipeline_l124_25;
  reg                 decode_to_execute_BYPASSABLE_MEMORY_STAGE;
  wire                when_Pipeline_l124_26;
  reg                 execute_to_memory_BYPASSABLE_MEMORY_STAGE;
  wire                when_Pipeline_l124_27;
  reg                 decode_to_execute_MEMORY_WR;
  wire                when_Pipeline_l124_28;
  reg                 execute_to_memory_MEMORY_WR;
  wire                when_Pipeline_l124_29;
  reg                 memory_to_writeBack_MEMORY_WR;
  wire                when_Pipeline_l124_30;
  reg                 decode_to_execute_MEMORY_MANAGMENT;
  wire                when_Pipeline_l124_31;
  reg                 decode_to_execute_IS_CSR;
  wire                when_Pipeline_l124_32;
  reg        [0:0]    decode_to_execute_ENV_CTRL;
  wire                when_Pipeline_l124_33;
  reg        [0:0]    execute_to_memory_ENV_CTRL;
  wire                when_Pipeline_l124_34;
  reg        [0:0]    memory_to_writeBack_ENV_CTRL;
  wire                when_Pipeline_l124_35;
  reg                 decode_to_execute_SRC_LESS_UNSIGNED;
  wire                when_Pipeline_l124_36;
  reg        [1:0]    decode_to_execute_ALU_BITWISE_CTRL;
  wire                when_Pipeline_l124_37;
  reg        [1:0]    decode_to_execute_SHIFT_CTRL;
  wire                when_Pipeline_l124_38;
  reg                 decode_to_execute_IS_MUL;
  wire                when_Pipeline_l124_39;
  reg                 execute_to_memory_IS_MUL;
  wire                when_Pipeline_l124_40;
  reg                 memory_to_writeBack_IS_MUL;
  wire                when_Pipeline_l124_41;
  reg                 decode_to_execute_IS_DIV;
  wire                when_Pipeline_l124_42;
  reg                 execute_to_memory_IS_DIV;
  wire                when_Pipeline_l124_43;
  reg                 decode_to_execute_IS_RS1_SIGNED;
  wire                when_Pipeline_l124_44;
  reg                 decode_to_execute_IS_RS2_SIGNED;
  wire                when_Pipeline_l124_45;
  reg        [1:0]    decode_to_execute_BRANCH_CTRL;
  wire                when_Pipeline_l124_46;
  reg        [31:0]   decode_to_execute_RS1;
  wire                when_Pipeline_l124_47;
  reg        [31:0]   decode_to_execute_RS2;
  wire                when_Pipeline_l124_48;
  reg                 decode_to_execute_SRC2_FORCE_ZERO;
  wire                when_Pipeline_l124_49;
  reg                 decode_to_execute_DO_EBREAK;
  wire                when_Pipeline_l124_50;
  reg        [31:0]   execute_to_memory_MEMORY_STORE_DATA_RF;
  wire                when_Pipeline_l124_51;
  reg        [31:0]   memory_to_writeBack_MEMORY_STORE_DATA_RF;
  wire                when_Pipeline_l124_52;
  reg        [31:0]   execute_to_memory_REGFILE_WRITE_DATA;
  wire                when_Pipeline_l124_53;
  reg        [31:0]   memory_to_writeBack_REGFILE_WRITE_DATA;
  wire                when_Pipeline_l124_54;
  reg        [31:0]   execute_to_memory_MUL_LL;
  wire                when_Pipeline_l124_55;
  reg        [33:0]   execute_to_memory_MUL_LH;
  wire                when_Pipeline_l124_56;
  reg        [33:0]   execute_to_memory_MUL_HL;
  wire                when_Pipeline_l124_57;
  reg        [33:0]   execute_to_memory_MUL_HH;
  wire                when_Pipeline_l124_58;
  reg        [33:0]   memory_to_writeBack_MUL_HH;
  wire                when_Pipeline_l124_59;
  reg                 execute_to_memory_BRANCH_DO;
  wire                when_Pipeline_l124_60;
  reg        [31:0]   execute_to_memory_BRANCH_CALC;
  wire                when_Pipeline_l124_61;
  reg        [31:0]   execute_to_memory_NEXT_PC2;
  wire                when_Pipeline_l124_62;
  reg                 execute_to_memory_TARGET_MISSMATCH2;
  wire                when_Pipeline_l124_63;
  reg        [51:0]   memory_to_writeBack_MUL_LOW;
  wire                when_Pipeline_l151;
  wire                when_Pipeline_l154;
  wire                when_Pipeline_l151_1;
  wire                when_Pipeline_l154_1;
  wire                when_Pipeline_l151_2;
  wire                when_Pipeline_l154_2;
  reg        [2:0]    IBusCachedPlugin_injector_port_state;
  wire                when_Fetcher_l391;
  wire                when_CsrPlugin_l1669;
  reg                 execute_CsrPlugin_csr_768;
  wire                when_CsrPlugin_l1669_1;
  reg                 execute_CsrPlugin_csr_836;
  wire                when_CsrPlugin_l1669_2;
  reg                 execute_CsrPlugin_csr_772;
  wire                when_CsrPlugin_l1669_3;
  reg                 execute_CsrPlugin_csr_834;
  wire       [1:0]    switch_CsrPlugin_l1031;
  reg        [31:0]   _zz_CsrPlugin_csrMapping_readDataInit;
  reg        [31:0]   _zz_CsrPlugin_csrMapping_readDataInit_1;
  reg        [31:0]   _zz_CsrPlugin_csrMapping_readDataInit_2;
  reg        [31:0]   _zz_CsrPlugin_csrMapping_readDataInit_3;
  wire                when_CsrPlugin_l1702;
  wire       [11:0]   _zz_when_CsrPlugin_l1709;
  wire                when_CsrPlugin_l1709;
  reg                 when_CsrPlugin_l1719;
  wire                when_CsrPlugin_l1717;
  wire                when_CsrPlugin_l1725;
  `ifndef SYNTHESIS
  reg [31:0] decode_BRANCH_CTRL_string;
  reg [31:0] _zz_decode_BRANCH_CTRL_string;
  reg [31:0] _zz_decode_to_execute_BRANCH_CTRL_string;
  reg [31:0] _zz_decode_to_execute_BRANCH_CTRL_1_string;
  reg [71:0] decode_SHIFT_CTRL_string;
  reg [71:0] _zz_decode_SHIFT_CTRL_string;
  reg [71:0] _zz_decode_to_execute_SHIFT_CTRL_string;
  reg [71:0] _zz_decode_to_execute_SHIFT_CTRL_1_string;
  reg [39:0] decode_ALU_BITWISE_CTRL_string;
  reg [39:0] _zz_decode_ALU_BITWISE_CTRL_string;
  reg [39:0] _zz_decode_to_execute_ALU_BITWISE_CTRL_string;
  reg [39:0] _zz_decode_to_execute_ALU_BITWISE_CTRL_1_string;
  reg [31:0] _zz_memory_to_writeBack_ENV_CTRL_string;
  reg [31:0] _zz_memory_to_writeBack_ENV_CTRL_1_string;
  reg [31:0] _zz_execute_to_memory_ENV_CTRL_string;
  reg [31:0] _zz_execute_to_memory_ENV_CTRL_1_string;
  reg [31:0] decode_ENV_CTRL_string;
  reg [31:0] _zz_decode_ENV_CTRL_string;
  reg [31:0] _zz_decode_to_execute_ENV_CTRL_string;
  reg [31:0] _zz_decode_to_execute_ENV_CTRL_1_string;
  reg [23:0] decode_SRC2_CTRL_string;
  reg [23:0] _zz_decode_SRC2_CTRL_string;
  reg [23:0] _zz_decode_to_execute_SRC2_CTRL_string;
  reg [23:0] _zz_decode_to_execute_SRC2_CTRL_1_string;
  reg [63:0] decode_ALU_CTRL_string;
  reg [63:0] _zz_decode_ALU_CTRL_string;
  reg [63:0] _zz_decode_to_execute_ALU_CTRL_string;
  reg [63:0] _zz_decode_to_execute_ALU_CTRL_1_string;
  reg [95:0] decode_SRC1_CTRL_string;
  reg [95:0] _zz_decode_SRC1_CTRL_string;
  reg [95:0] _zz_decode_to_execute_SRC1_CTRL_string;
  reg [95:0] _zz_decode_to_execute_SRC1_CTRL_1_string;
  reg [31:0] execute_BRANCH_CTRL_string;
  reg [31:0] _zz_execute_BRANCH_CTRL_string;
  reg [71:0] execute_SHIFT_CTRL_string;
  reg [71:0] _zz_execute_SHIFT_CTRL_string;
  reg [23:0] execute_SRC2_CTRL_string;
  reg [23:0] _zz_execute_SRC2_CTRL_string;
  reg [95:0] execute_SRC1_CTRL_string;
  reg [95:0] _zz_execute_SRC1_CTRL_string;
  reg [63:0] execute_ALU_CTRL_string;
  reg [63:0] _zz_execute_ALU_CTRL_string;
  reg [39:0] execute_ALU_BITWISE_CTRL_string;
  reg [39:0] _zz_execute_ALU_BITWISE_CTRL_string;
  reg [31:0] _zz_decode_BRANCH_CTRL_1_string;
  reg [71:0] _zz_decode_SHIFT_CTRL_1_string;
  reg [39:0] _zz_decode_ALU_BITWISE_CTRL_1_string;
  reg [31:0] _zz_decode_ENV_CTRL_1_string;
  reg [23:0] _zz_decode_SRC2_CTRL_1_string;
  reg [63:0] _zz_decode_ALU_CTRL_1_string;
  reg [95:0] _zz_decode_SRC1_CTRL_1_string;
  reg [31:0] memory_ENV_CTRL_string;
  reg [31:0] _zz_memory_ENV_CTRL_string;
  reg [31:0] execute_ENV_CTRL_string;
  reg [31:0] _zz_execute_ENV_CTRL_string;
  reg [31:0] writeBack_ENV_CTRL_string;
  reg [31:0] _zz_writeBack_ENV_CTRL_string;
  reg [95:0] _zz_decode_SRC1_CTRL_2_string;
  reg [63:0] _zz_decode_ALU_CTRL_2_string;
  reg [23:0] _zz_decode_SRC2_CTRL_2_string;
  reg [31:0] _zz_decode_ENV_CTRL_2_string;
  reg [39:0] _zz_decode_ALU_BITWISE_CTRL_2_string;
  reg [71:0] _zz_decode_SHIFT_CTRL_2_string;
  reg [31:0] _zz_decode_BRANCH_CTRL_2_string;
  reg [95:0] decode_to_execute_SRC1_CTRL_string;
  reg [63:0] decode_to_execute_ALU_CTRL_string;
  reg [23:0] decode_to_execute_SRC2_CTRL_string;
  reg [31:0] decode_to_execute_ENV_CTRL_string;
  reg [31:0] execute_to_memory_ENV_CTRL_string;
  reg [31:0] memory_to_writeBack_ENV_CTRL_string;
  reg [39:0] decode_to_execute_ALU_BITWISE_CTRL_string;
  reg [71:0] decode_to_execute_SHIFT_CTRL_string;
  reg [31:0] decode_to_execute_BRANCH_CTRL_string;
  `endif

  reg [55:0] IBusCachedPlugin_predictor_history [0:255];
  (* ram_style = "distributed" *) reg [31:0] RegFilePlugin_regFile [0:31] /* verilator public */ ;
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
