ananyasindam-deepgrid/soc_1.1/HW/src/dgrid_pkg.vhd

---------------------------------------------------------------------------
-- Copyright [2026] [Deepgrid Semi Pvt Ltd]
--
-- Author: Deepgrid Semi Pvt Ltd
---------------------------------------------------------------------------

--------------- 
-- This file defines constants that are used by dgrid implementation
-- Contains component declaration
---------------

library std;
use std.standard.all;
LIBRARY ieee;
USE ieee.std_logic_1164.all;
use IEEE.numeric_std.all;
use IEEE.MATH_REAL.ALL;
use work.config.all;

package dgrid_pkg is

---------
-- Number of threads
---------

constant tid_max_c:integer:=16;

subtype tid_t is unsigned(3 DOWNTO 0);

subtype tid_mask_t  is std_logic_vector(tid_t'length-1 downto 0);

--------
-- Message queue to communicate with host
--------

constant msgq_in_num_c          :integer:=2;                        -- Number of inbox fifo

constant msgq_in_depth_c        :integer:=11;                       -- number of bits required to represent number of inbox messages

constant msgq_in_max_c          :integer:=(2**msgq_in_depth_c-1);   -- inbox size

constant msgq_out_depth_c       :integer:=11;                       -- number of bits required to represent number of outbox messages

constant msgq_out_max_c         :integer:=(2**msgq_out_depth_c-1);  -- outbox size

----------
-- AXI read bus signal definitions
----------

subtype axi_araddr_t is std_logic_vector(31 downto 0);
subtype axi_arlen_t is std_logic_vector(7 downto 0);
subtype axi_arvalid_t is std_logic;     
subtype axi_arid_t is std_logic_vector(0 downto 0);
subtype axi_arlock_t is std_logic_vector(0 downto 0);
subtype axi_arcache_t is std_logic_vector(3 downto 0);
subtype axi_arprot_t is std_logic_vector(2 downto 0);
subtype axi_arqos_t is std_logic_vector(3 downto 0);
subtype axi_rid_t is std_logic_vector(0 downto 0);             
subtype axi_rvalid_t is std_logic;
subtype axi_rlast_t is std_logic;
subtype axi_rdata_t is std_logic_vector(31 downto 0);
subtype axi_rdata64_t is std_logic_vector(63 downto 0);
subtype axi_rdata128_t is std_logic_vector(127 downto 0);
subtype axi_rresp_t is std_logic_vector(1 downto 0);
subtype axi_arready_t is std_logic;
subtype axi_rready_t is std_logic;
subtype axi_arburst_t is std_logic_vector(1 downto 0);
subtype axi_arsize_t is std_logic_vector(2 downto 0);
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
